BehrensG/ETH6C12MUX/img/PCB1_V1.0.jpg

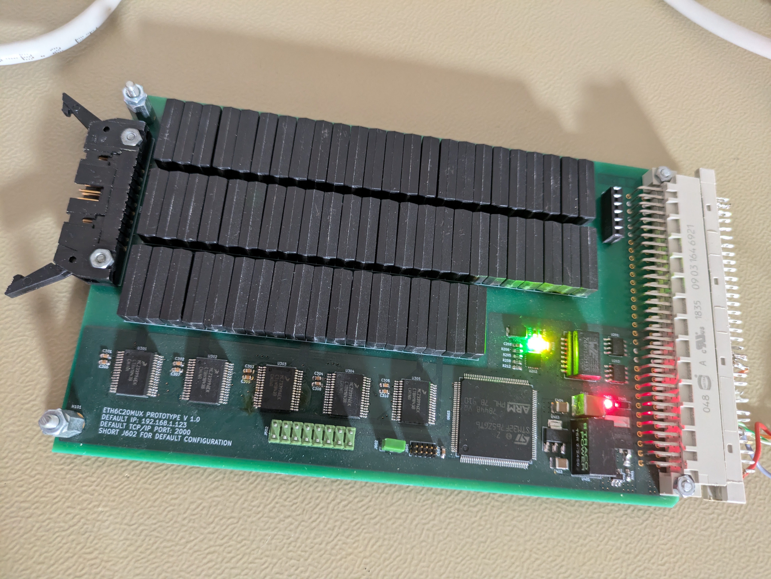
img/PCB1_V1.0.jpg
