BehrensG/ETH6C12MUX/img/PCB3_V1.0.jpg

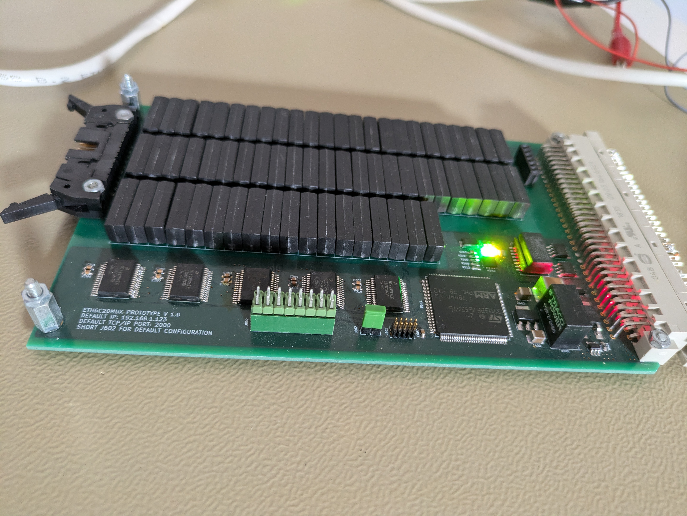
img/PCB3_V1.0.jpg
