BehrensG/ETH6C12MUX/hardware/project/PDF/ETH6C20MUX-B_SilkS.pdf

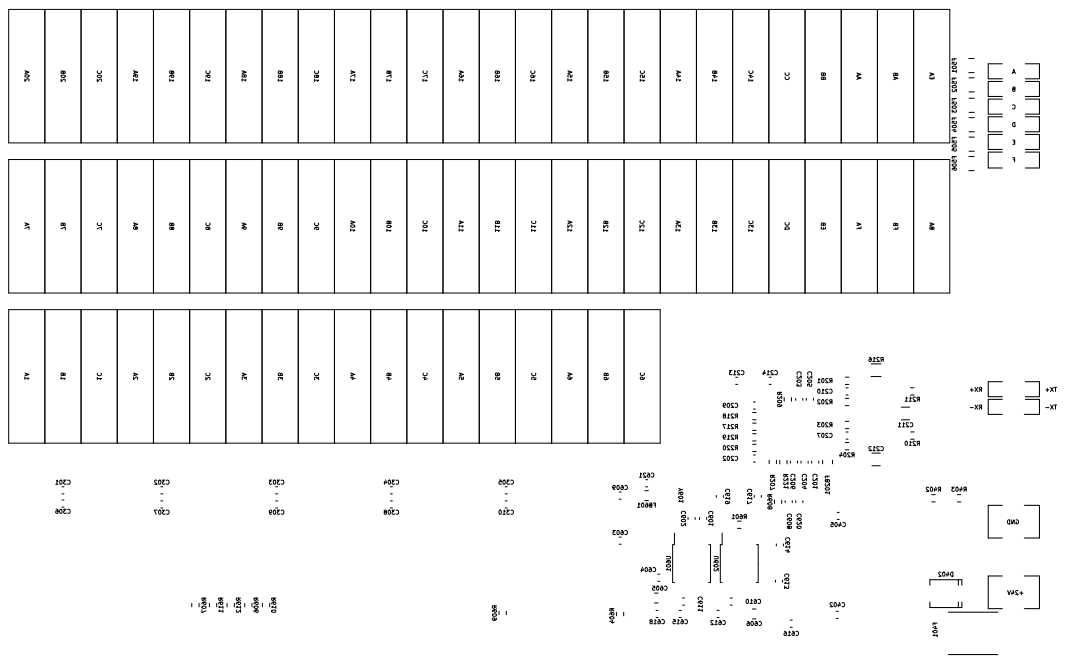
[picture p3: page 1]

RX- RX+ TX- TX+ GND
