BehrensG/ETH6C12MUX/hardware/project/PDF/SPI6C20MUX-F_SilkS.pdf

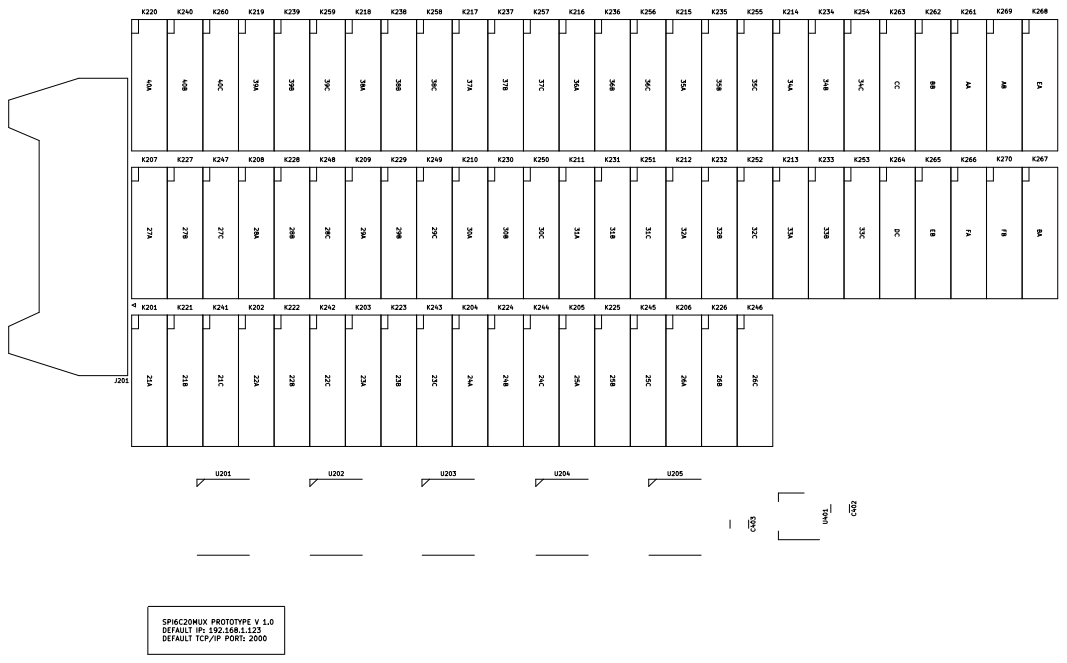
[picture p4: page 1]

27A 27B 27C 28A 28B 28C 29A 29B 29C 30A 30B 30C 31A 31B 31C 32A 32B 32C 33A 33B 33C DCEB ABEA FABA 21B 21C 22A 22B 22C 23A 23B 23C 24A 24B 24C 25A 25B 25C 26A 26B 26C FB 21A 40A 40B 40C 39A 39B 39C 38A 38B 38C 37A 37B 37C 36A 36B 36C 35A 35B 35C 34A 34B 34C CCBBAA

SPI6C20MUX PROTOTYPE V 1.0 DEFAULT IP: 192.168.1.123 DEFAULT TCP/IP PORT: 2000
