BehrensG/ETH6C12MUX/hardware/project/PDF/ETH6C20MUX-B_Mask.pdf

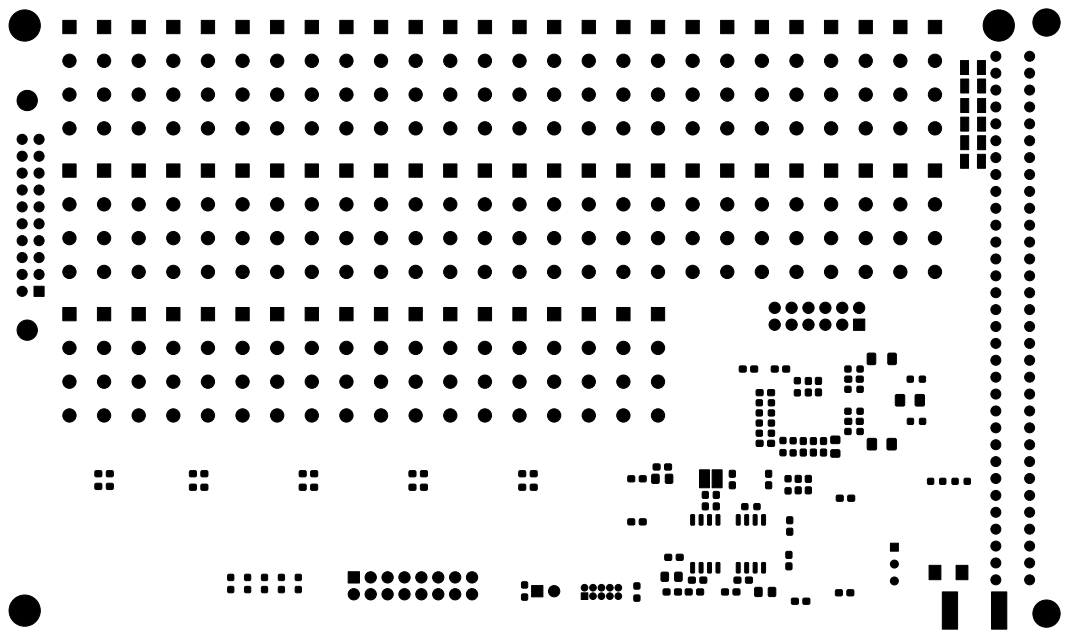
[picture p5: page 1]
