BehrensG/ETH6C12MUX/hardware/project/PDF/ETH6C20MUX-B_Paste.pdf

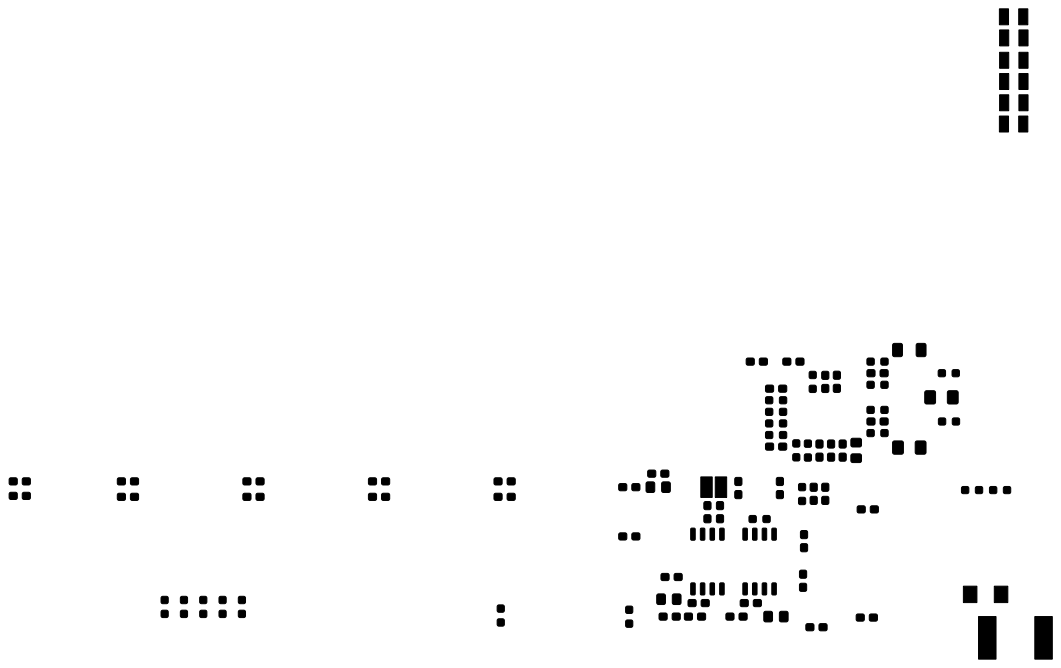
[picture p6: page 1]
