BehrensG/ETH6C12MUX/hardware/project/PDF/ETH6C20MUX-Bottom.pdf

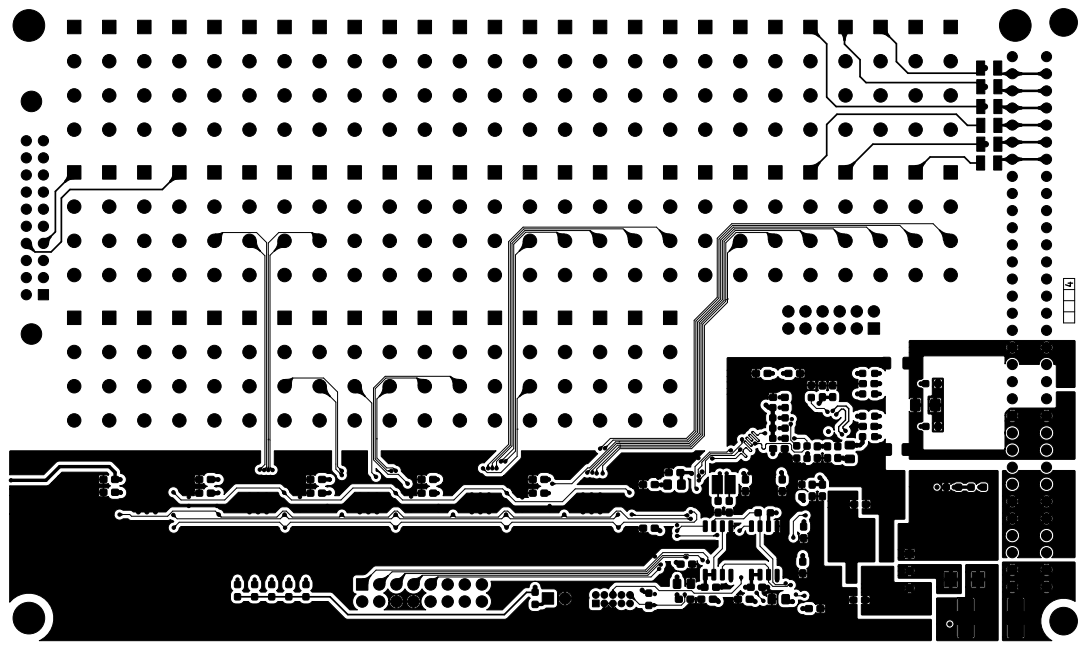
[picture p7: page 1]
