BehrensG/ETH6C12MUX/hardware/project/PDF/ETH6C20MUX-F_Mask.pdf

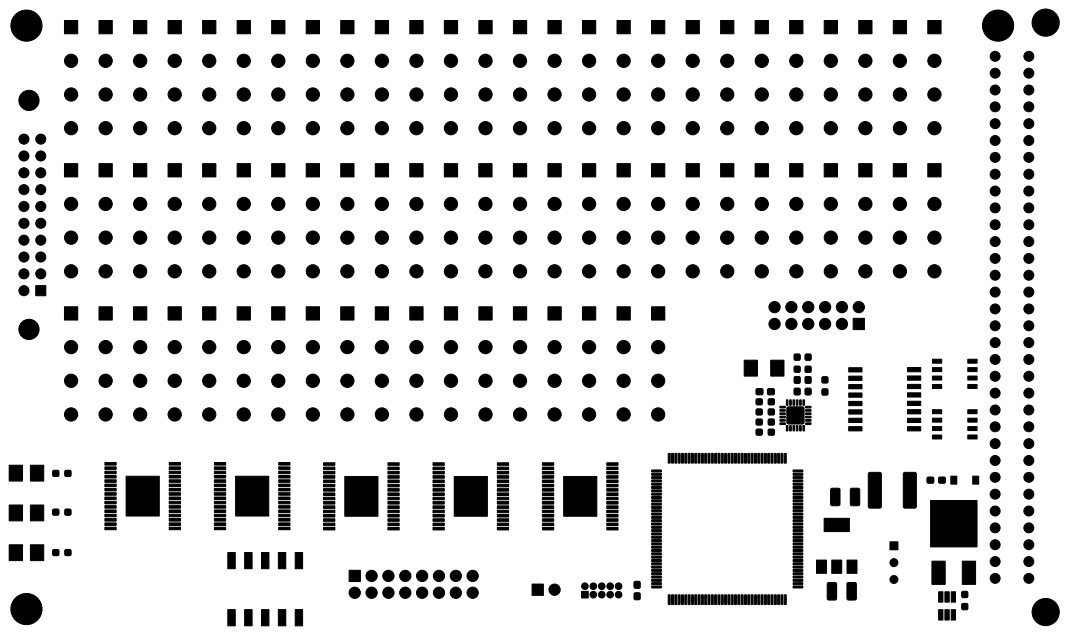
[picture p8: page 1]
