BehrensG/ETH6C12MUX/hardware/project/PDF/ETH6C20MUX-F_Paste.pdf

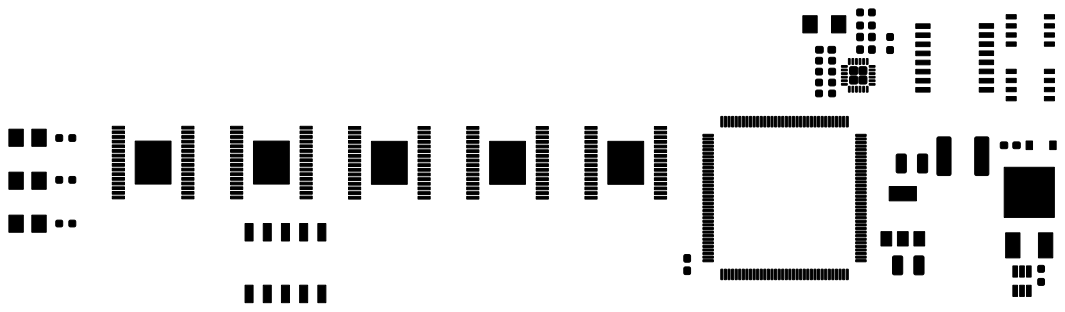
[picture p9: page 1]
