BehrensG/ETH6C12MUX/hardware/project/PDF/ETH6C20MUX-F_SilkS.pdf

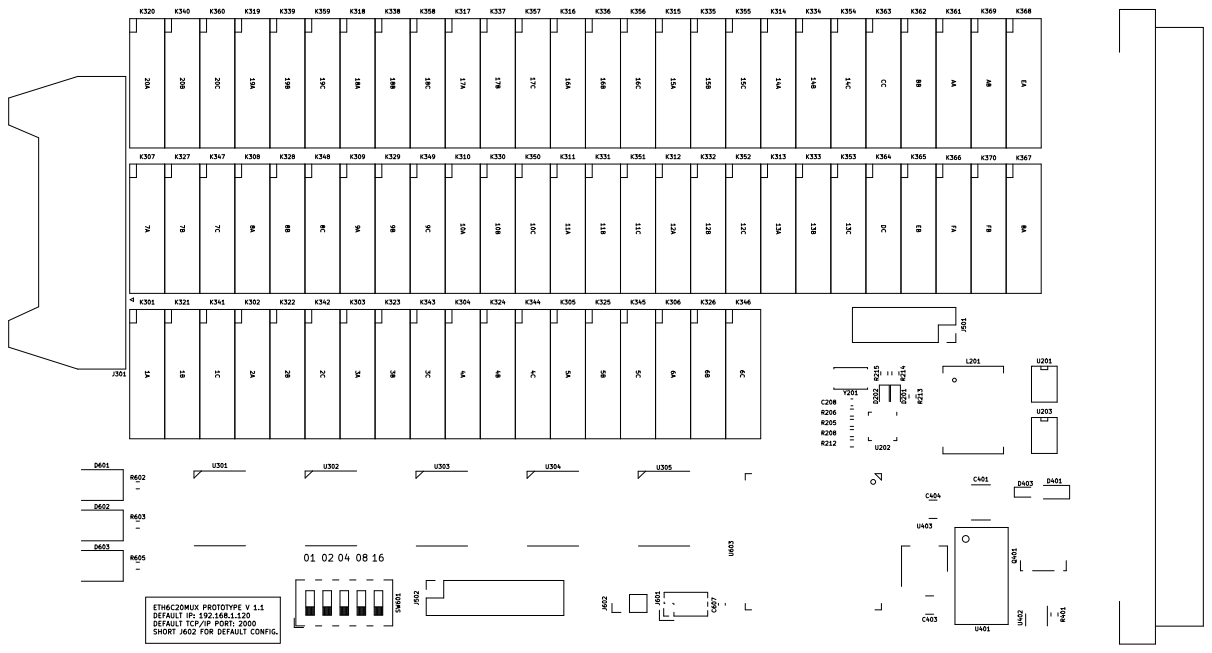
[picture p10: page 1]
