BehrensG/ETH6C12MUX/hardware/project/PDF/ETH6C20MUX-GND.pdf

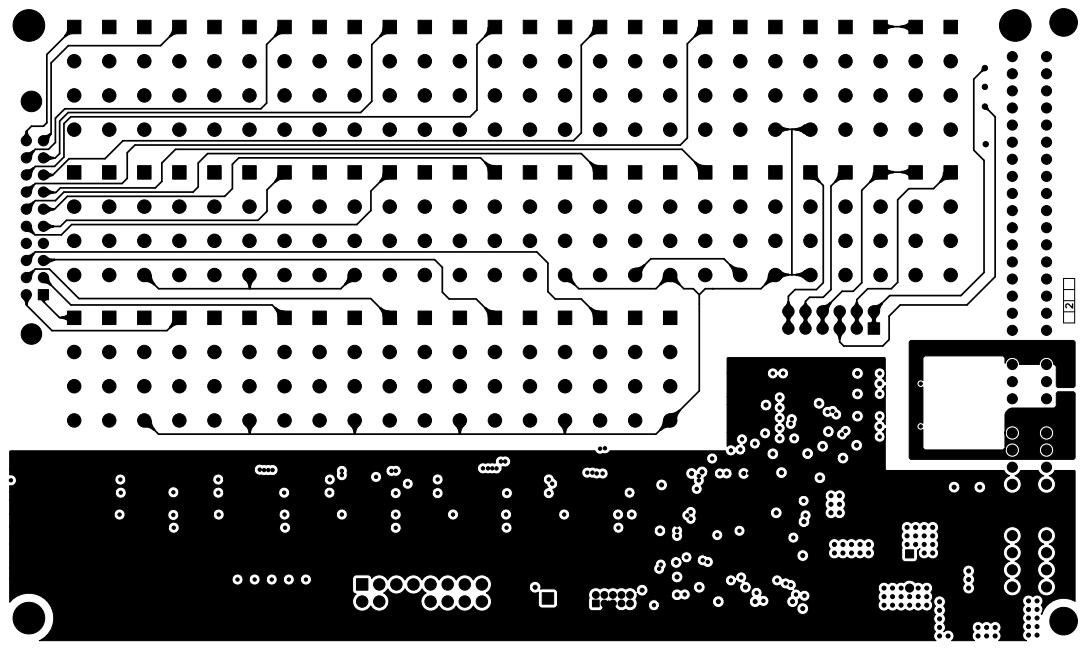
[picture p11: page 1]
