BehrensG/ETH6C12MUX/hardware/project/PDF/ETH6C20MUX-Power.pdf

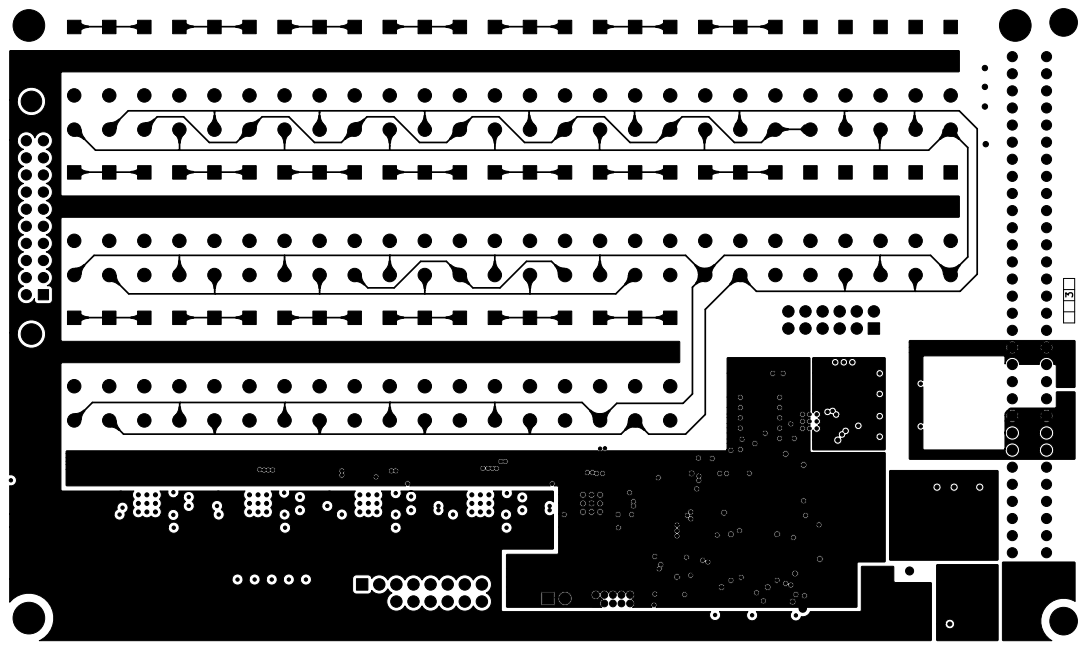
[picture p12: page 1]
