BehrensG/ETH6C12MUX/hardware/project/PDF/ETH6C20MUX-Top.pdf

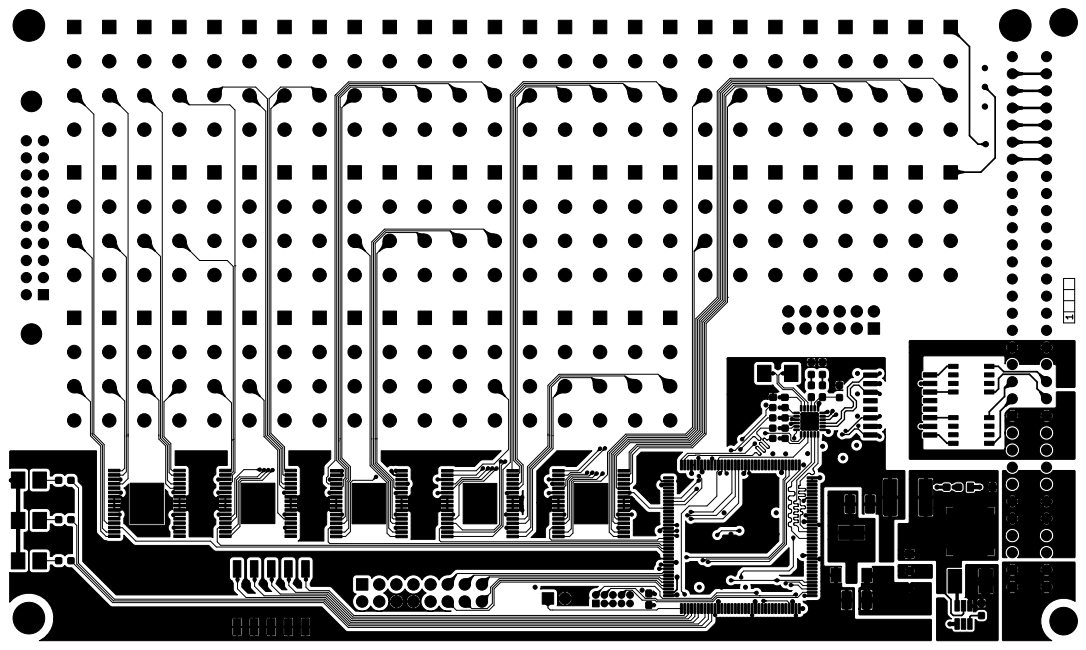
[picture p13: page 1]
