BehrensG/ETH6C12MUX/hardware/project/PDF/SPI6C20MUX-B_Mask.pdf

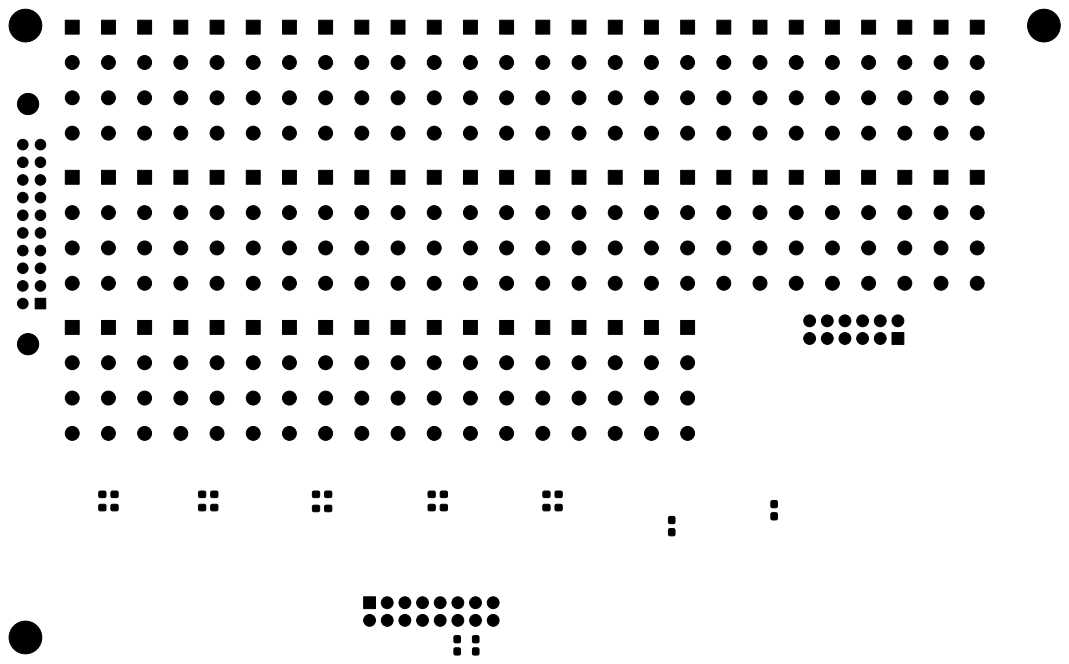
[picture p14: page 1]
