BehrensG/ETH6C12MUX/hardware/project/PDF/SPI6C20MUX-B_Paste.pdf

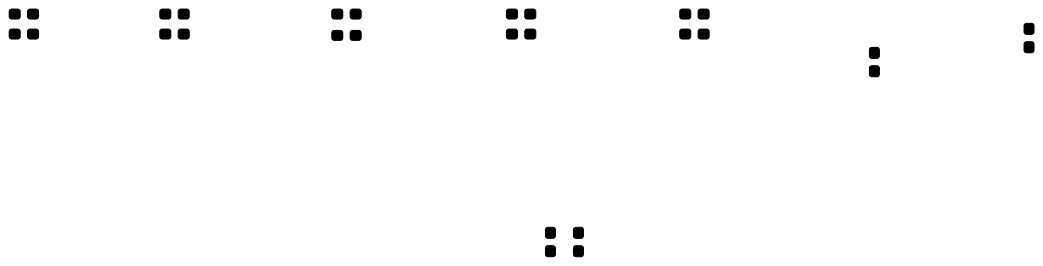
[picture p15: page 1]
