BehrensG/ETH6C12MUX/hardware/project/PDF/SPI6C20MUX-Bottom.pdf

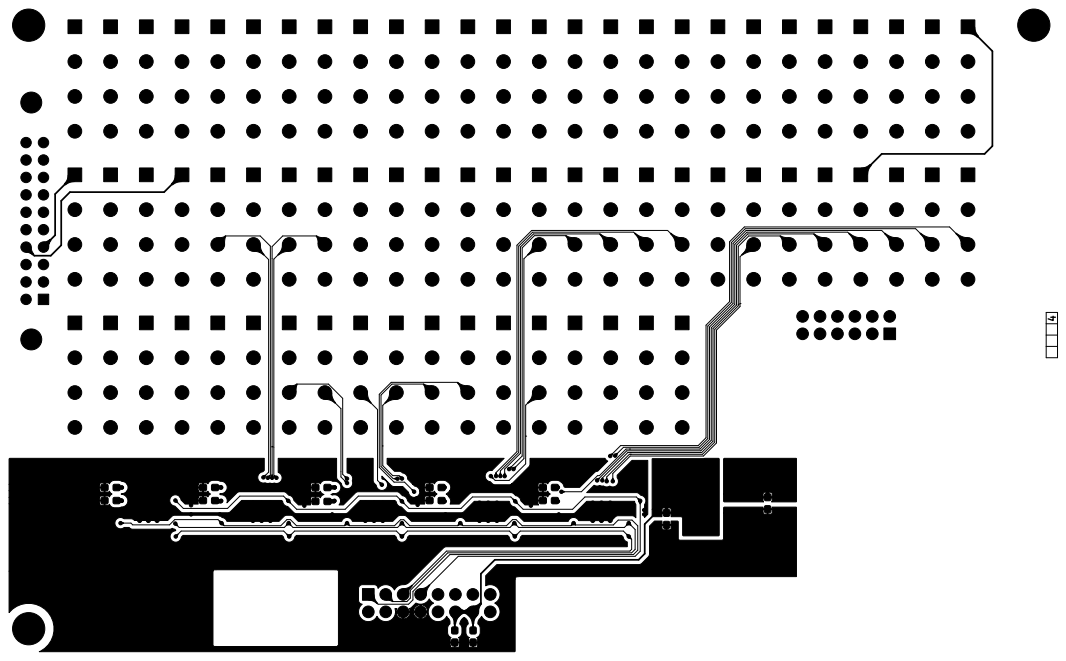
[picture p17: page 1]
