BehrensG/ETH6C12MUX/hardware/project/PDF/SPI6C20MUX-F_Mask.pdf

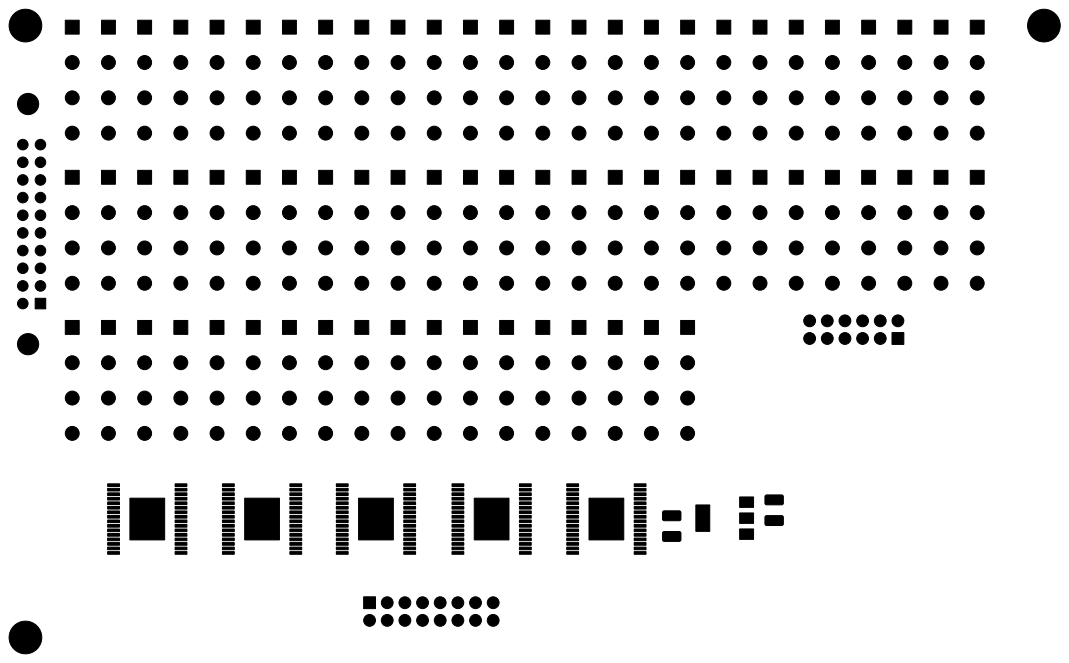
[picture p18: page 1]
