BehrensG/ETH6C12MUX/hardware/project/PDF/SPI6C20MUX-GND.pdf

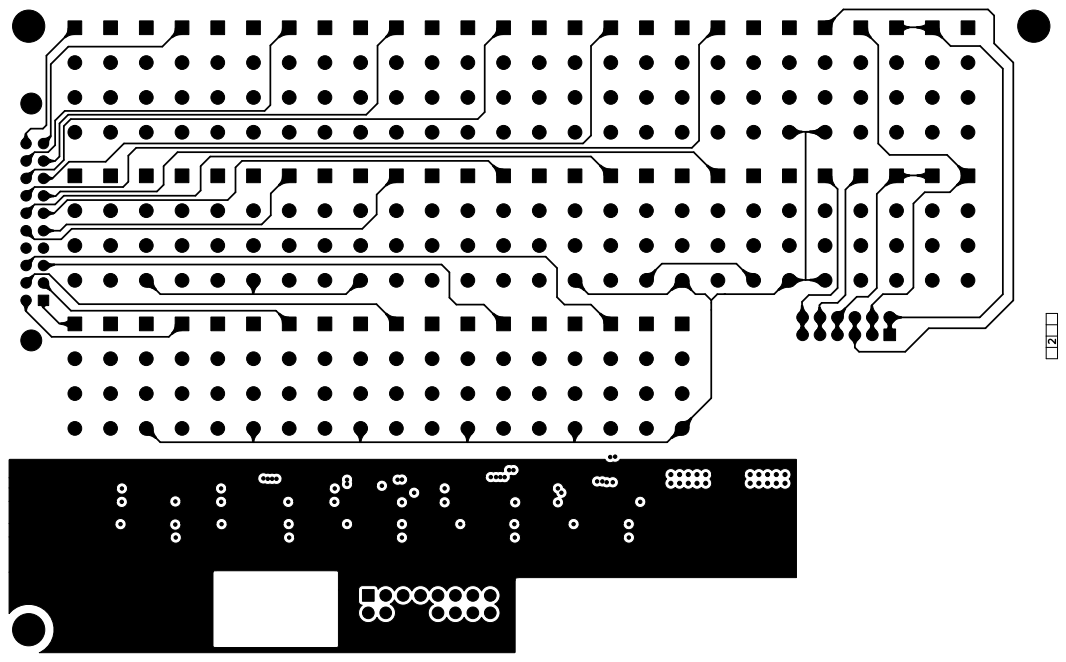
[picture p19: page 1]
