BehrensG/ETH6C12MUX/hardware/project/PDF/SPI6C20MUX-Power.pdf

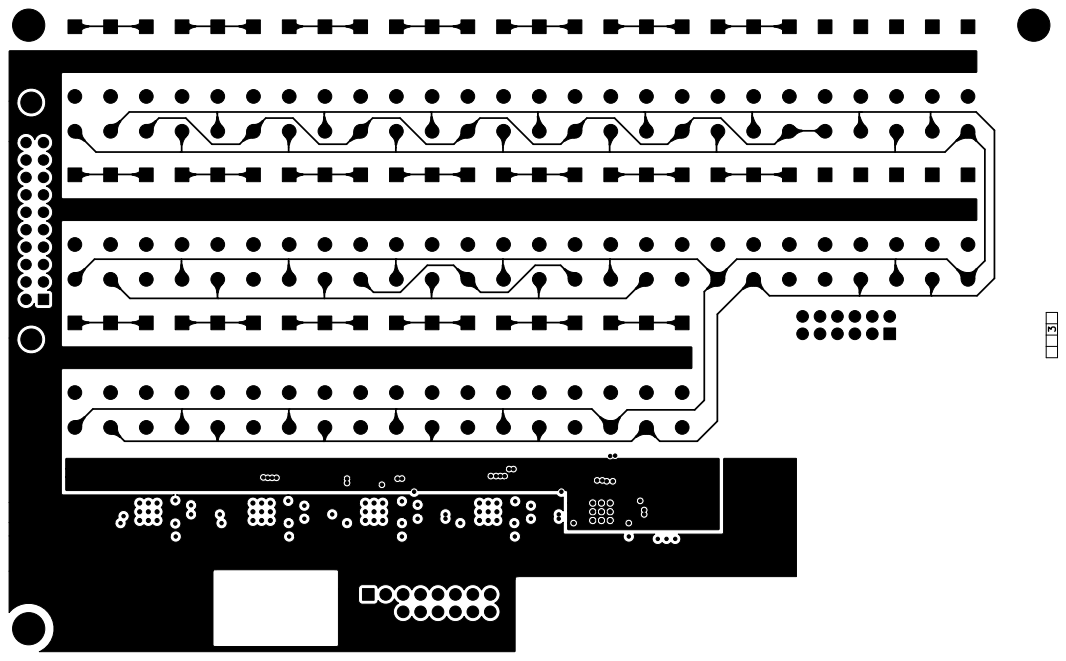
[picture p20: page 1]
