BehrensG/ETH6C12MUX/hardware/project/PDF/SPI6C20MUX-Top.pdf

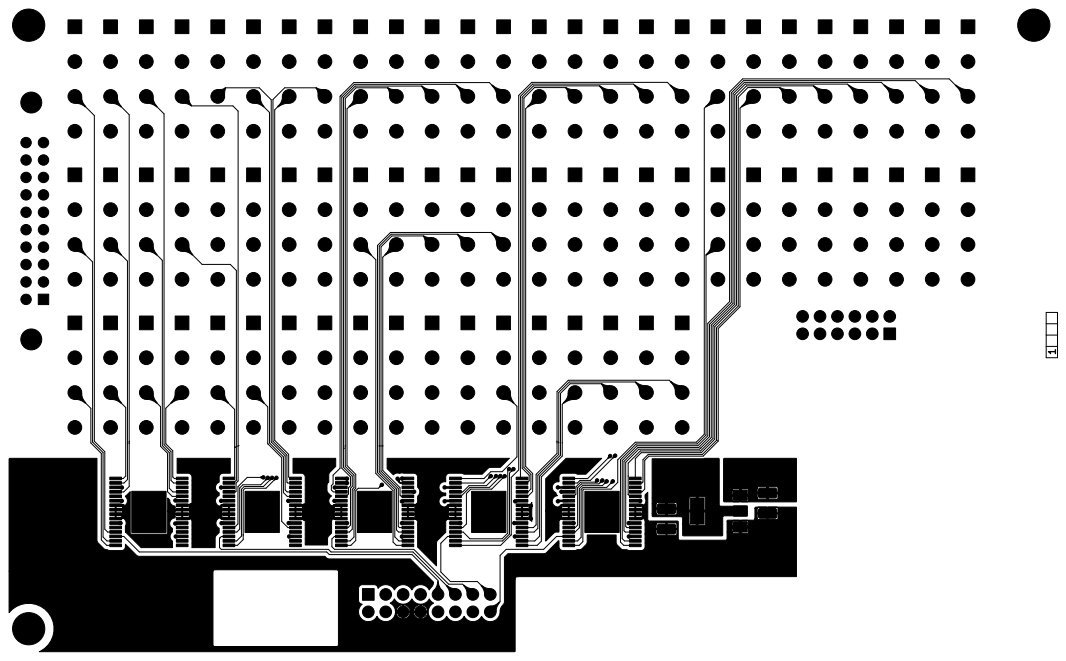
[picture p21: page 1]
