BehrensG/ETH6C12MUX/hardware/project/SPI6C20MUX/SPI6C20MUX.kicad_pcb

## KiCad design hardware/project/SPI6C20MUX/SPI6C20MUX.kicad_pcb (2021-03-21)

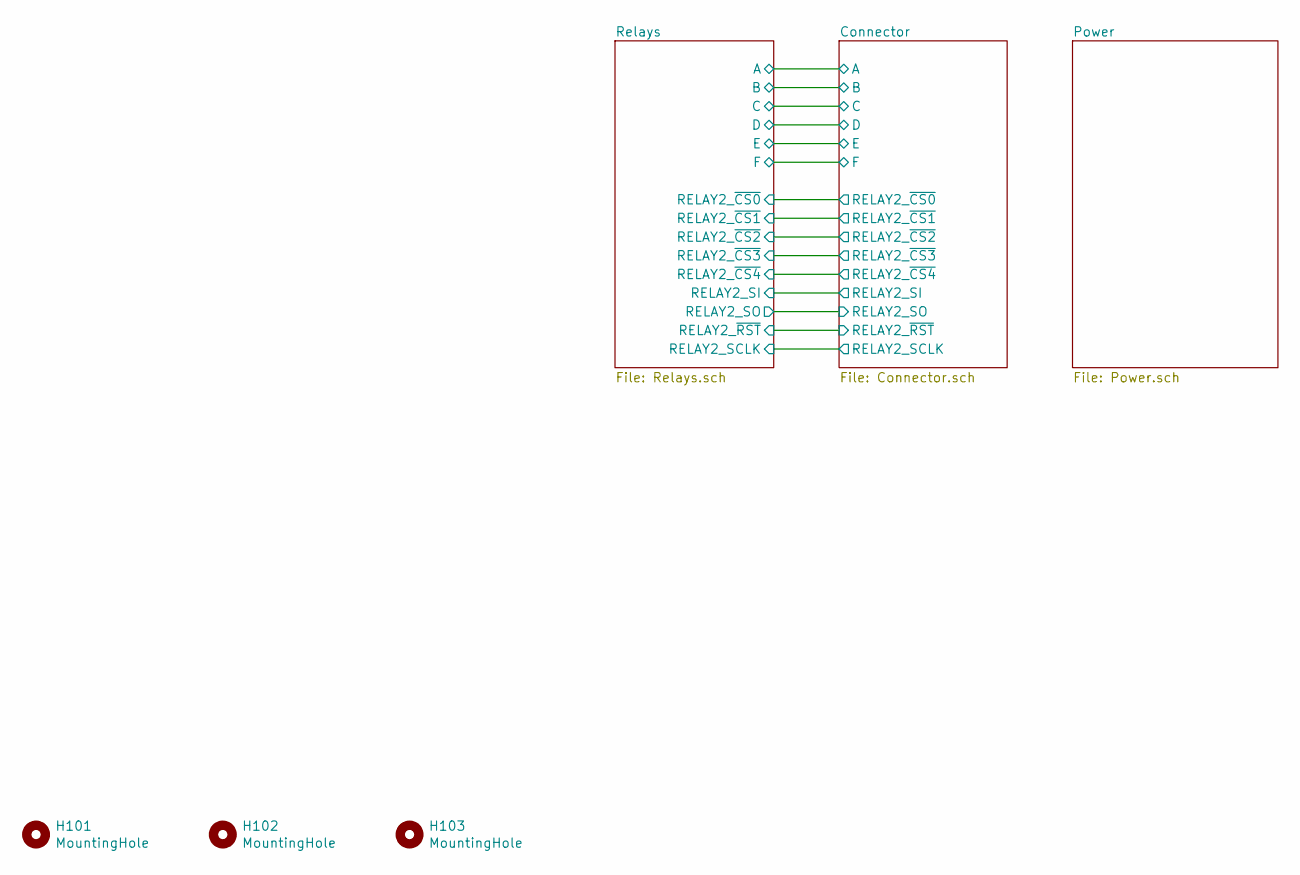
[picture p22: schematic SPI6C20MUX.sch]

Parts:
H101, H102, H103: MountingHole; MountingHole_2.7mm_M2.5_DIN965_Pad

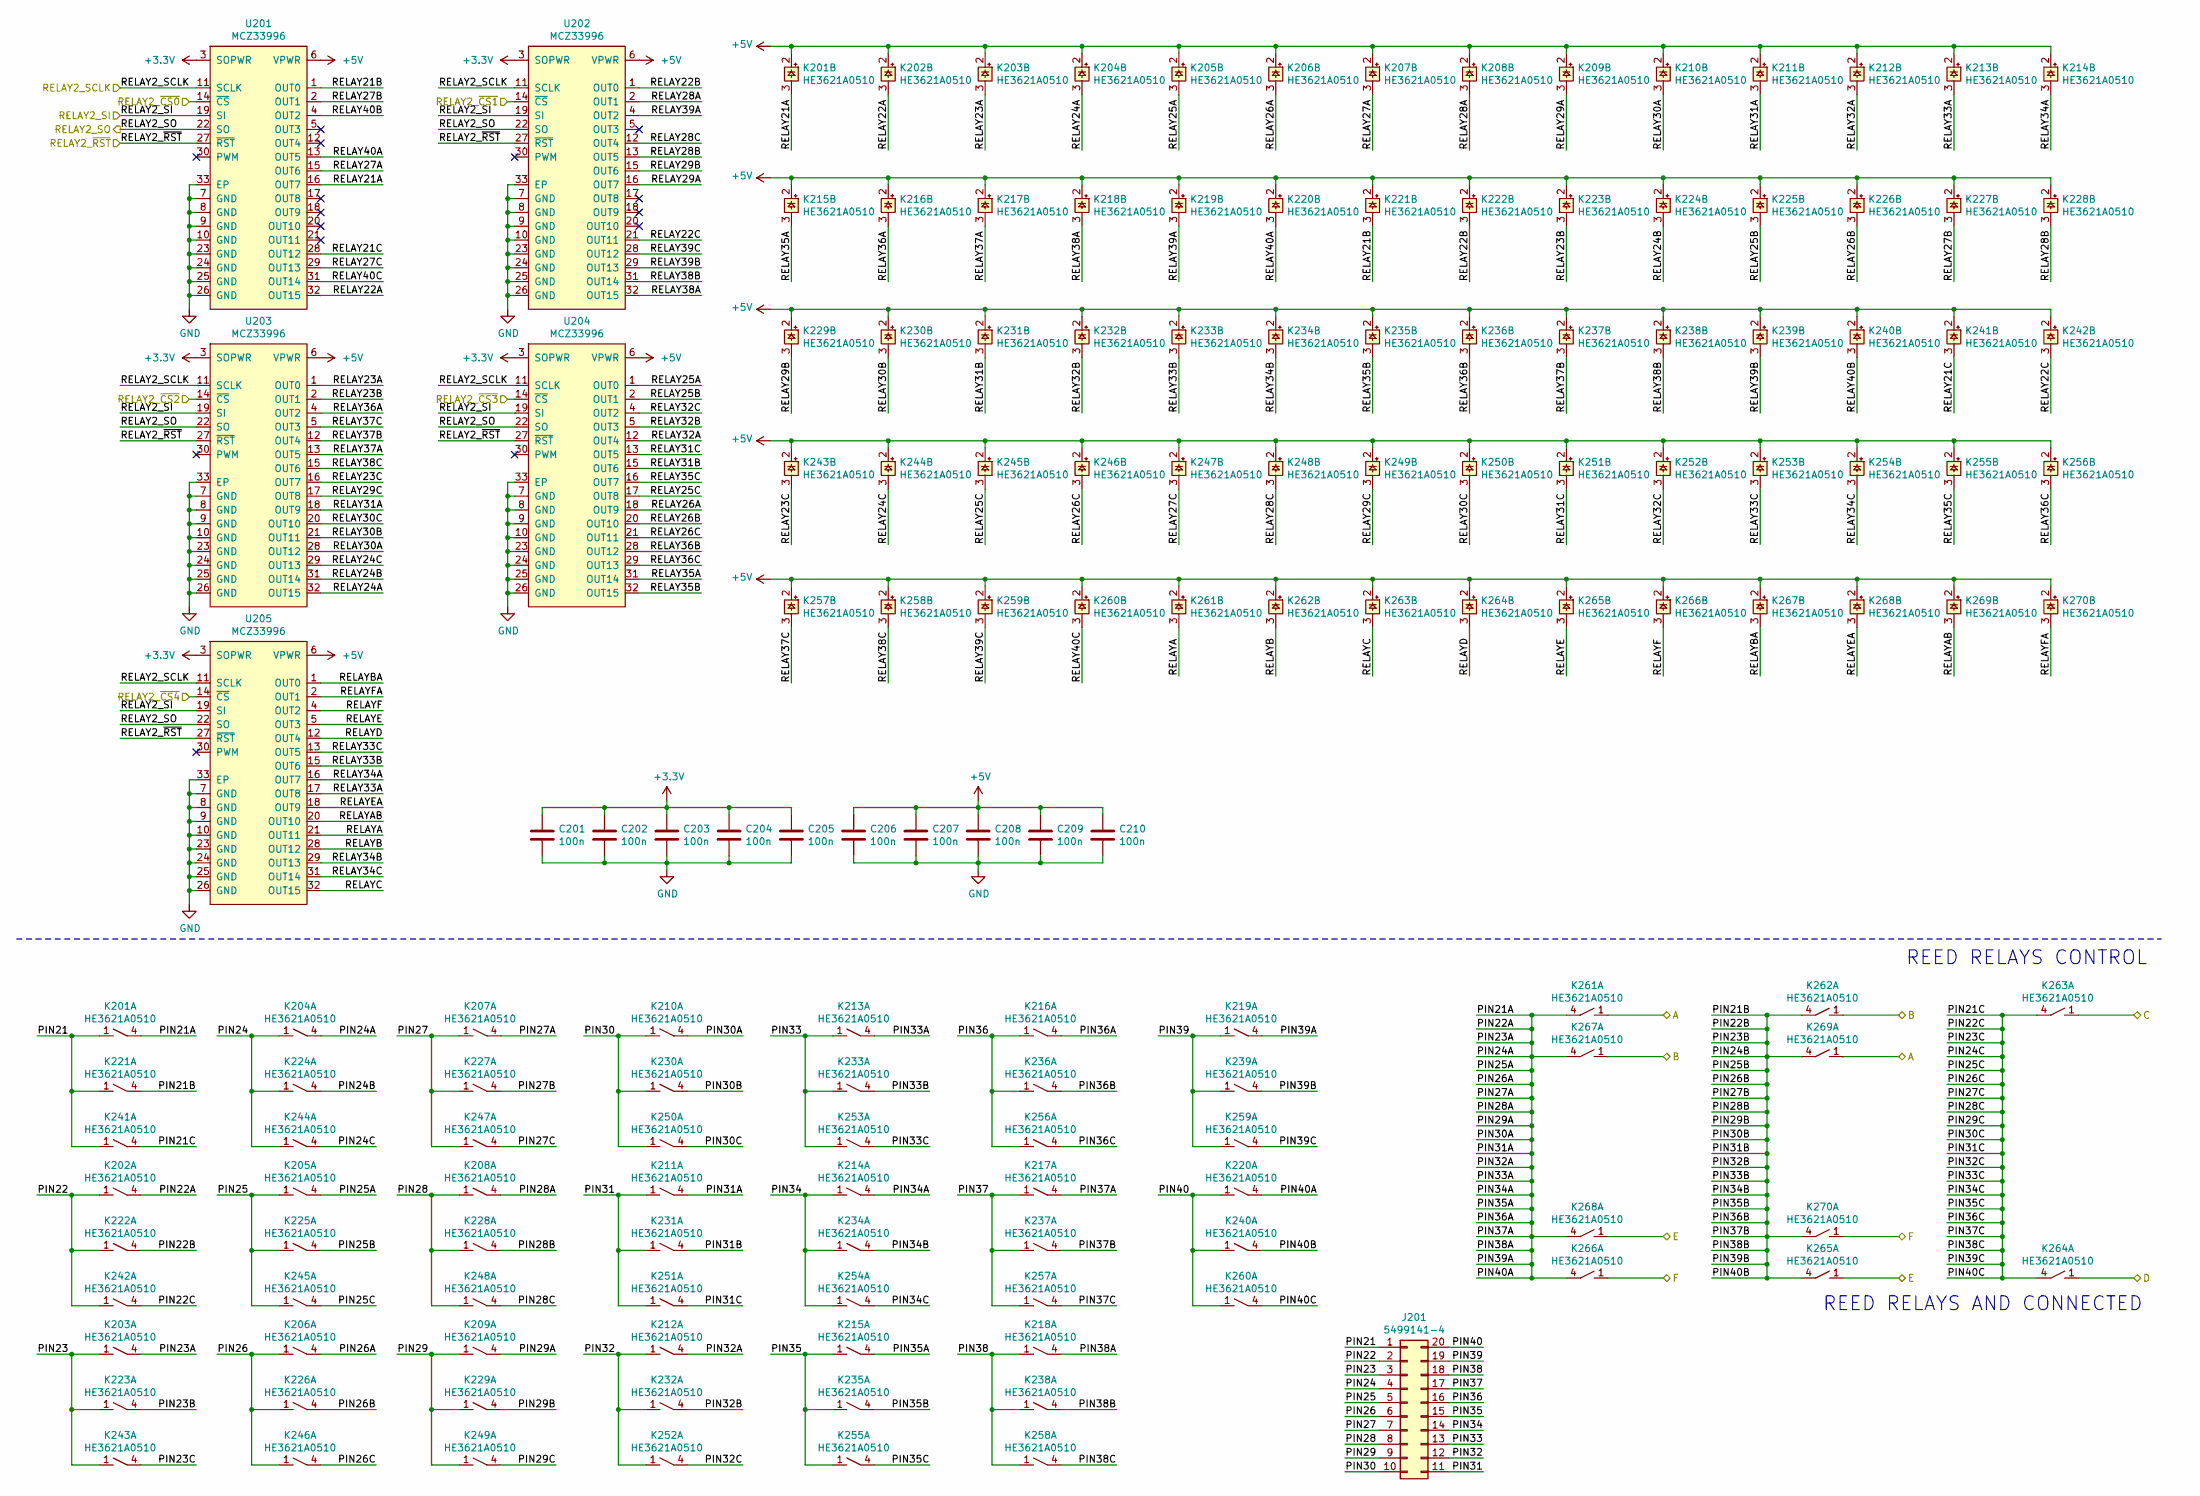
[picture p23: schematic Relays.sch]

Parts:
C201, C202, C203, C204, C205, C206, C207, C208, C209, C210: 100n; C_0603_1608Metric_Pad1.05x0.95mm_HandSolder
J201: 5499141-4; IDC-Header_2x10_P2.54mm_Horizontal_Lock
K201, K202, K203, K204, K205, K206, K207, K208, K209, K210, K211, K212, K213, K214, K215, K216, K217, K218, K219, K220, K221, K222, K223, K224, K225, K226, K227, K228, K229, K230, K231, K232, K233, K234, K235, K236, K237, K238, K239, K240, K241, K242, K243, K244, K245, K246, K247, K248, K249, K250, K251, K252, K253, K254, K255, K256, K257, K258, K259, K260, K261, K262, K263, K264, K265, K266, K267, K268, K269, K270: HE3621A0510; HE360_x-5331272-5
U201, U202, U203, U204, U205: MCZ33996; HSOP-32-1EP_7.5x11.0mm_P0.65mm_ThermalVias

Connections:
+3V3: C201.1, C202.1, C203.1, C204.1, C205.1, U201.3 (SOPWR), U202.3 (SOPWR), U203.3 (SOPWR), U204.3 (SOPWR), U205.3 (SOPWR); also elsewhere on the board
+5V: C206.1, C207.1, C208.1, C209.1, C210.1, K201.2, K202.2, K203.2, K204.2, K205.2, K206.2, K207.2, K208.2, K209.2, K210.2, K211.2, K212.2, K213.2, K214.2, K215.2, K216.2, K217.2, K218.2, K219.2, K220.2, K221.2, K222.2, K223.2, K224.2, K225.2, K226.2, K227.2, K228.2, K229.2, K230.2, K231.2, K232.2, K233.2, K234.2, K235.2, K236.2, K237.2, K238.2, K239.2, K240.2, K241.2, K242.2, K243.2, K244.2, K245.2, K246.2, K247.2, K248.2, K249.2, K250.2, K251.2, K252.2, K253.2, K254.2, K255.2, K256.2, K257.2, K258.2, K259.2, K260.2, K261.2, K262.2, K263.2, K264.2, K265.2, K266.2, K267.2, K268.2, K269.2, K270.2, U201.6 (VPWR), U202.6 (VPWR), U203.6 (VPWR), U204.6 (VPWR), U205.6 (VPWR); also elsewhere on the board
/Connector/A: K261.1, K269.1; also elsewhere on the board
/Connector/B: K262.1, K267.1; also elsewhere on the board
/Connector/C: K263.1; also elsewhere on the board
/Connector/D: K264.1; also elsewhere on the board
/Connector/E: K265.1, K268.1; also elsewhere on the board
/Connector/F: K266.1, K270.1; also elsewhere on the board
/Connector/RELAY2_SCLK: U201.11 (SCLK), U202.11 (SCLK), U203.11 (SCLK), U204.11 (SCLK), U205.11 (SCLK); also elsewhere on the board
/Connector/RELAY2_SI: U201.19 (SI), U202.19 (SI), U203.19 (SI), U204.19 (SI), U205.19 (SI); also elsewhere on the board
/Connector/RELAY2_SO: U201.22 (SO), U202.22 (SO), U203.22 (SO), U204.22 (SO), U205.22 (SO); also elsewhere on the board
/Connector/RELAY2_~CS0: U201.14 (~CS); also elsewhere on the board
/Connector/RELAY2_~CS1: U202.14 (~CS); also elsewhere on the board
/Connector/RELAY2_~CS2: U203.14 (~CS); also elsewhere on the board
/Connector/RELAY2_~CS3: U204.14 (~CS); also elsewhere on the board
/Connector/RELAY2_~CS4: U205.14 (~CS); also elsewhere on the board
/Connector/RELAY2_~RST: U201.27 (~RST), U202.27 (~RST), U203.27 (~RST), U204.27 (~RST), U205.27 (~RST); also elsewhere on the board
/Relays/PIN21: J201.1, K201.1, K221.1, K241.1
/Relays/PIN21A: K201.4, K202.4, K203.4, K204.4, K205.4, K206.4, K207.4, K208.4, K209.4, K210.4, K211.4, K212.4, K213.4, K214.4, K215.4, K216.4, K217.4, K218.4, K219.4, K220.4, K261.4, K266.4, K267.4, K268.4
/Relays/PIN21B: K221.4, K222.4, K223.4, K224.4, K225.4, K226.4, K227.4, K228.4, K229.4, K230.4, K231.4, K232.4, K233.4, K234.4, K235.4, K236.4, K237.4, K238.4, K239.4, K240.4, K262.4, K265.4, K269.4, K270.4
/Relays/PIN21C: K241.4, K242.4, K243.4, K244.4, K245.4, K246.4, K247.4, K248.4, K249.4, K250.4, K251.4, K252.4, K253.4, K254.4, K255.4, K256.4, K257.4, K258.4, K259.4, K260.4, K263.4, K264.4
/Relays/PIN22: J201.2, K202.1, K222.1, K242.1
/Relays/PIN23: J201.3, K203.1, K223.1, K243.1
/Relays/PIN24: J201.4, K204.1, K224.1, K244.1
/Relays/PIN25: J201.5, K205.1, K225.1, K245.1
/Relays/PIN26: J201.6, K206.1, K226.1, K246.1
/Relays/PIN27: J201.7, K207.1, K227.1, K247.1
/Relays/PIN28: J201.8, K208.1, K228.1, K248.1
/Relays/PIN29: J201.9, K209.1, K229.1, K249.1
/Relays/PIN30: J201.10, K210.1, K230.1, K250.1
/Relays/PIN31: J201.11, K211.1, K231.1, K251.1
/Relays/PIN32: J201.12, K212.1, K232.1, K252.1
/Relays/PIN33: J201.13, K213.1, K233.1, K253.1
/Relays/PIN34: J201.14, K214.1, K234.1, K254.1
/Relays/PIN35: J201.15, K215.1, K235.1, K255.1
/Relays/PIN36: J201.16, K216.1, K236.1, K256.1
/Relays/PIN37: J201.17, K217.1, K237.1, K257.1
/Relays/PIN38: J201.18, K218.1, K238.1, K258.1
/Relays/PIN39: J201.19, K219.1, K239.1, K259.1
/Relays/PIN40: J201.20, K220.1, K240.1, K260.1
/Relays/RELAY21A: K201.3, U201.16 (OUT7)
/Relays/RELAY21B: K221.3, U201.1 (OUT0)
/Relays/RELAY21C: K241.3, U201.28 (OUT12)
/Relays/RELAY22A: K202.3, U201.32 (OUT15)
/Relays/RELAY22B: K222.3, U202.1 (OUT0)
/Relays/RELAY22C: K242.3, U202.21 (OUT11)
/Relays/RELAY23A: K203.3, U203.1 (OUT0)
/Relays/RELAY23B: K223.3, U203.2 (OUT1)
/Relays/RELAY23C: K243.3, U203.16 (OUT7)
/Relays/RELAY24A: K204.3, U203.32 (OUT15)
/Relays/RELAY24B: K224.3, U203.31 (OUT14)
/Relays/RELAY24C: K244.3, U203.29 (OUT13)
/Relays/RELAY25A: K205.3, U204.1 (OUT0)
/Relays/RELAY25B: K225.3, U204.2 (OUT1)
/Relays/RELAY25C: K245.3, U204.17 (OUT8)
/Relays/RELAY26A: K206.3, U204.18 (OUT9)
/Relays/RELAY26B: K226.3, U204.20 (OUT10)
/Relays/RELAY26C: K246.3, U204.21 (OUT11)
/Relays/RELAY27A: K207.3, U201.15 (OUT6)
/Relays/RELAY27B: K227.3, U201.2 (OUT1)
/Relays/RELAY27C: K247.3, U201.29 (OUT13)
/Relays/RELAY28A: K208.3, U202.2 (OUT1)
/Relays/RELAY28B: K228.3, U202.13 (OUT5)
/Relays/RELAY28C: K248.3, U202.12 (OUT4)
/Relays/RELAY29A: K209.3, U202.16 (OUT7)
/Relays/RELAY29B: K229.3, U202.15 (OUT6)
/Relays/RELAY29C: K249.3, U203.17 (OUT8)
/Relays/RELAY30A: K210.3, U203.28 (OUT12)
/Relays/RELAY30B: K230.3, U203.21 (OUT11)
/Relays/RELAY30C: K250.3, U203.20 (OUT10)
/Relays/RELAY31A: K211.3, U203.18 (OUT9)
/Relays/RELAY31B: K231.3, U204.15 (OUT6)
/Relays/RELAY31C: K251.3, U204.13 (OUT5)
/Relays/RELAY32A: K212.3, U204.12 (OUT4)
/Relays/RELAY32B: K232.3, U204.5 (OUT3)
/Relays/RELAY32C: K252.3, U204.4 (OUT2)
/Relays/RELAY33A: K213.3, U205.17 (OUT8)
/Relays/RELAY33B: K233.3, U205.15 (OUT6)
/Relays/RELAY33C: K253.3, U205.13 (OUT5)
/Relays/RELAY34A: K214.3, U205.16 (OUT7)
/Relays/RELAY34B: K234.3, U205.29 (OUT13)
/Relays/RELAY34C: K254.3, U205.31 (OUT14)
/Relays/RELAY35A: K215.3, U204.31 (OUT14)
/Relays/RELAY35B: K235.3, U204.32 (OUT15)
/Relays/RELAY35C: K255.3, U204.16 (OUT7)
/Relays/RELAY36A: K216.3, U203.4 (OUT2)
/Relays/RELAY36B: K236.3, U204.28 (OUT12)
/Relays/RELAY36C: K256.3, U204.29 (OUT13)
/Relays/RELAY37A: K217.3, U203.13 (OUT5)
/Relays/RELAY37B: K237.3, U203.12 (OUT4)
/Relays/RELAY37C: K257.3, U203.5 (OUT3)
/Relays/RELAY38A: K218.3, U202.32 (OUT15)
/Relays/RELAY38B: K238.3, U202.31 (OUT14)
/Relays/RELAY38C: K258.3, U203.15 (OUT6)
/Relays/RELAY39A: K219.3, U202.4 (OUT2)
/Relays/RELAY39B: K239.3, U202.29 (OUT13)
/Relays/RELAY39C: K259.3, U202.28 (OUT12)
/Relays/RELAY40A: K220.3, U201.13 (OUT5)
/Relays/RELAY40B: K240.3, U201.4 (OUT2)
/Relays/RELAY40C: K260.3, U201.31 (OUT14)
/Relays/RELAYA: K261.3, U205.21 (OUT11)
/Relays/RELAYAB: K269.3, U205.20 (OUT10)
/Relays/RELAYB: K262.3, U205.28 (OUT12)
/Relays/RELAYBA: K267.3, U205.1 (OUT0)
/Relays/RELAYC: K263.3, U205.32 (OUT15)
/Relays/RELAYD: K264.3, U205.12 (OUT4)
/Relays/RELAYE: K265.3, U205.5 (OUT3)
/Relays/RELAYEA: K268.3, U205.18 (OUT9)
/Relays/RELAYF: K266.3, U205.4 (OUT2)
/Relays/RELAYFA: K270.3, U205.2 (OUT1)
GND: C201.2, C202.2, C203.2, C204.2, C205.2, C206.2, C207.2, C208.2, C209.2, C210.2, U201.7 (GND), U201.8 (GND), U201.9 (GND), U201.10 (GND), U201.23 (GND), U201.24 (GND), U201.25 (GND), U201.26 (GND), U201.33 (EP), U202.7 (GND), U202.8 (GND), U202.9 (GND), U202.10 (GND), U202.23 (GND), U202.24 (GND), U202.25 (GND), U202.26 (GND), U202.33 (EP), U203.7 (GND), U203.8 (GND), U203.9 (GND), U203.10 (GND), U203.23 (GND), U203.24 (GND), U203.25 (GND), U203.26 (GND), U203.33 (EP), U204.7 (GND), U204.8 (GND), U204.9 (GND), U204.10 (GND), U204.23 (GND), U204.24 (GND), U204.25 (GND), U204.26 (GND), U204.33 (EP), U205.7 (GND), U205.8 (GND), U205.9 (GND), U205.10 (GND), U205.23 (GND), U205.24 (GND), U205.25 (GND), U205.26 (GND), U205.33 (EP); also elsewhere on the board

Notes on the sheet:
REED RELAYS AND CONNECTED
REED RELAYS CONTROL

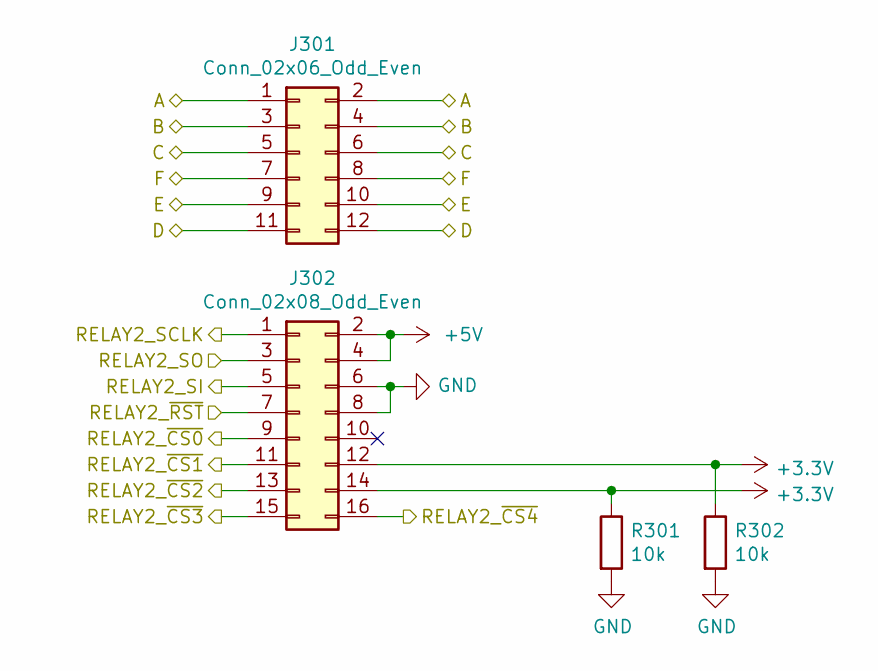
[picture p24: schematic Connector.sch]

Parts:
J301: Conn_02x06_Odd_Even; PinHeader_2x06_P2.54mm_Vertical
J302: Conn_02x08_Odd_Even; PinHeader_2x08_P2.54mm_Vertical
R301, R302: 10k; R_0603_1608Metric_Pad1.05x0.95mm_HandSolder

Connections:
+3V3: J302.12, J302.14, R301.1, R302.1; also elsewhere on the board
+5V: J302.2, J302.4; also elsewhere on the board
/Connector/A: J301.1, J301.2; also elsewhere on the board
/Connector/B: J301.3, J301.4; also elsewhere on the board
/Connector/C: J301.5, J301.6; also elsewhere on the board
/Connector/D: J301.11, J301.12; also elsewhere on the board
/Connector/E: J301.9, J301.10; also elsewhere on the board
/Connector/F: J301.7, J301.8; also elsewhere on the board
/Connector/RELAY2_SCLK: J302.1; also elsewhere on the board
/Connector/RELAY2_SI: J302.5; also elsewhere on the board
/Connector/RELAY2_SO: J302.3; also elsewhere on the board
/Connector/RELAY2_~CS0: J302.9; also elsewhere on the board
/Connector/RELAY2_~CS1: J302.11; also elsewhere on the board
/Connector/RELAY2_~CS2: J302.13; also elsewhere on the board
/Connector/RELAY2_~CS3: J302.15; also elsewhere on the board
/Connector/RELAY2_~CS4: J302.16; also elsewhere on the board
/Connector/RELAY2_~RST: J302.7; also elsewhere on the board
GND: J302.6, J302.8, R301.2, R302.2; also elsewhere on the board

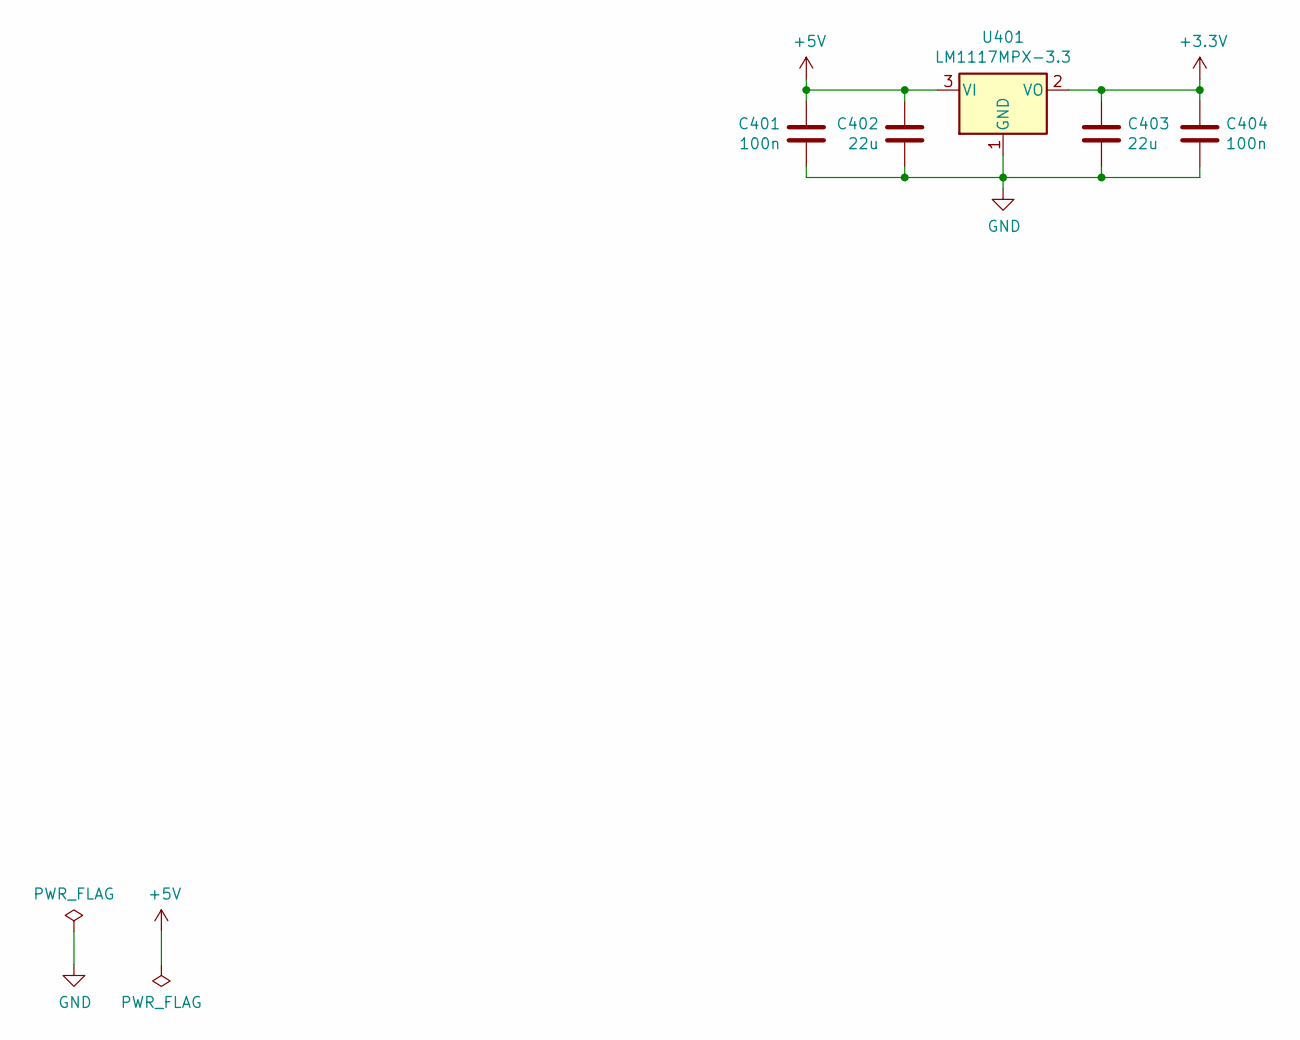
[picture p25: schematic Power.sch]

Parts:
C401, C404: 100n; C_0603_1608Metric_Pad1.05x0.95mm_HandSolder
C402, C403: 22u; C_1210_3225Metric_Pad1.42x2.65mm_HandSolder
U401: LM1117MPX-3.3; SOT-223-3_TabPin2

Connections:
+3V3: C403.1, C404.1, U401.2 (VO); also elsewhere on the board
+5V: C401.1, C402.1, U401.3 (VI); also elsewhere on the board
GND: C401.2, C402.2, C403.2, C404.2, U401.1 (GND); also elsewhere on the board

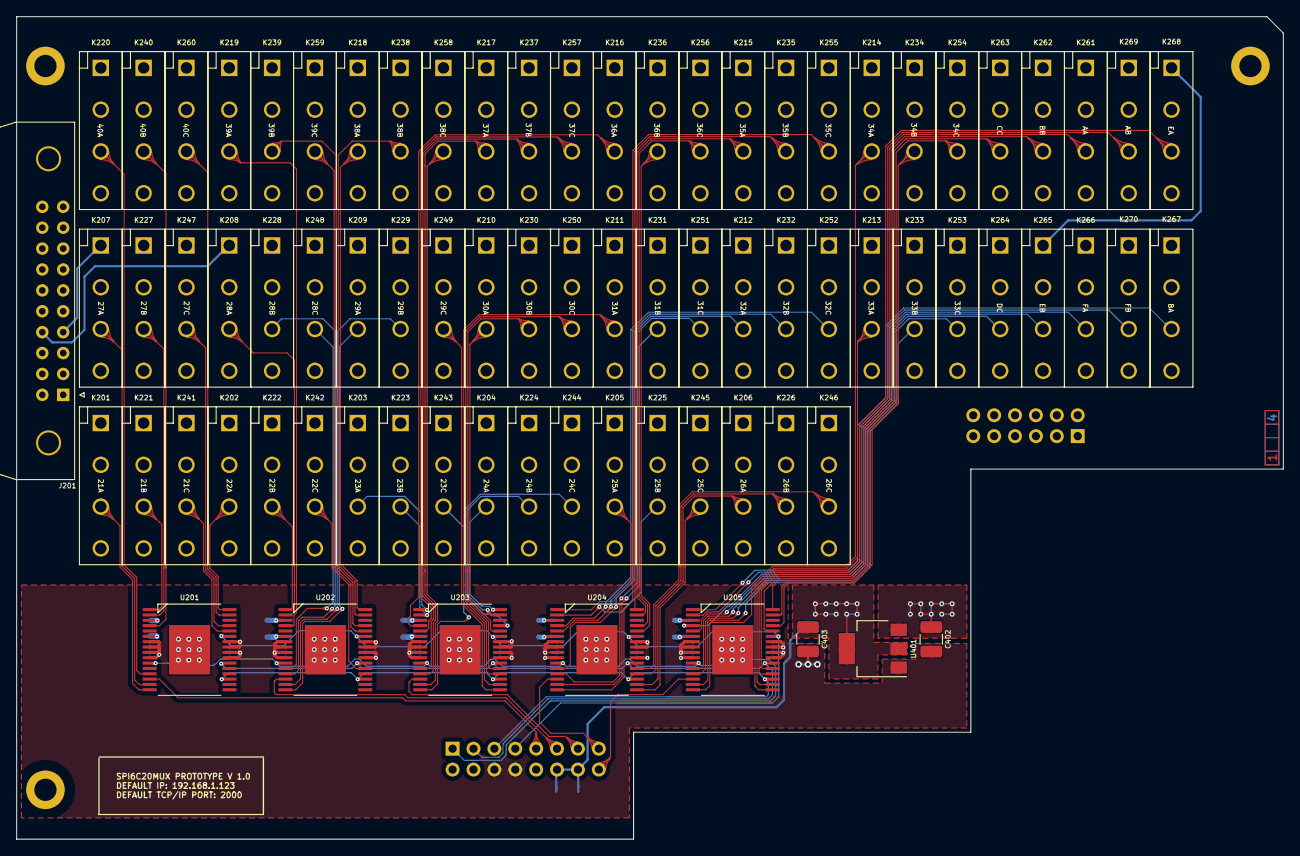
[picture p26: board SPI6C20MUX.kicad_pcb from above]

Board: 4 copper layers, 154.0 x 100.0 mm, 98 parts (0 on the bottom side), 111 nets.
