BehrensG/ETH6C12MUX/hardware/project/ETH6C20MUX/ETH6C20MUX.kicad_pcb

## KiCad design hardware/project/ETH6C20MUX/ETH6C20MUX.kicad_pcb (2021-03-21)

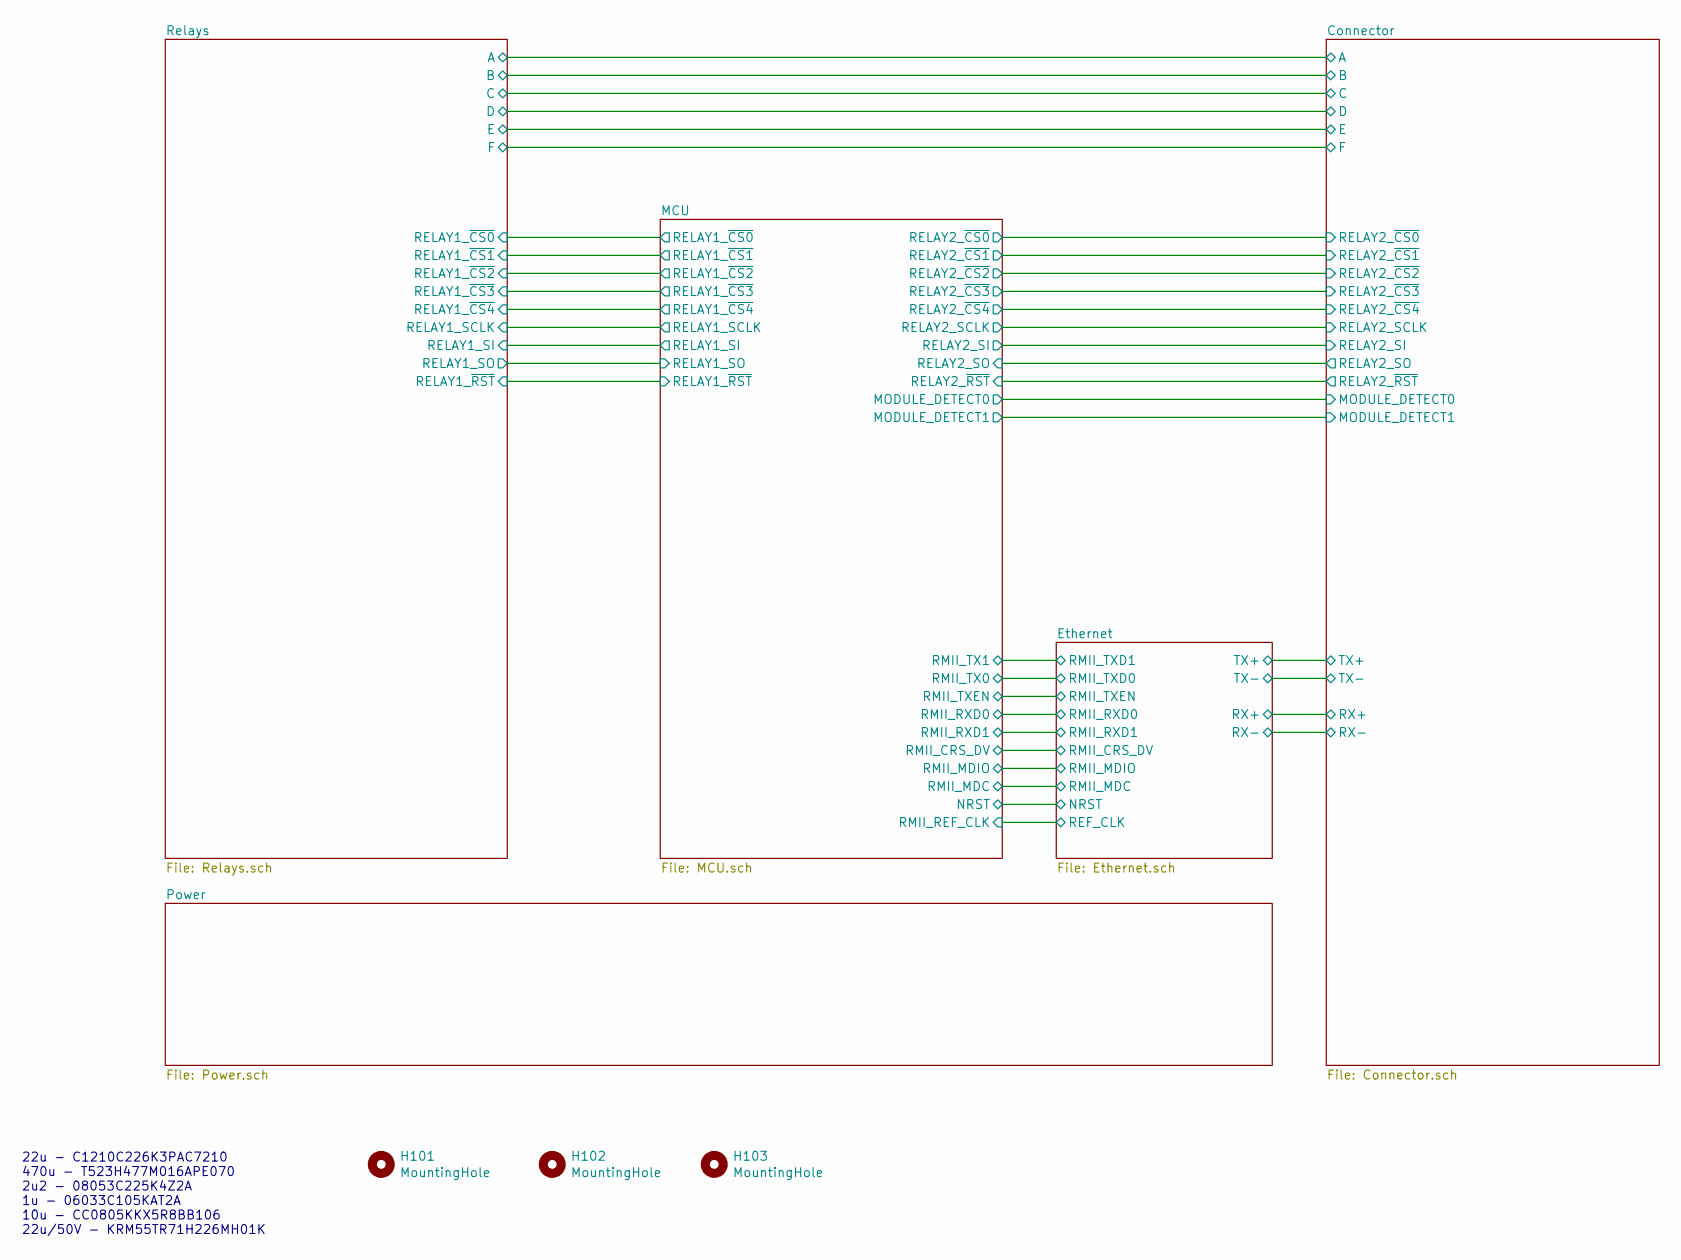
[picture p27: schematic ETH6C20MUX.sch, Main]

Parts:
H101, H102, H103: MountingHole; MountingHole_2.7mm_M2.5_DIN965_Pad

Notes on the sheet:
22u - C1210C226K3PAC7210 470u - T523H477M016APE070 2u2 - 08053C225K4Z2A 1u - 06033C105KAT2A 10u - CC0805KKX5R8BB106 22u/50V - KRM55TR71H226MH01K

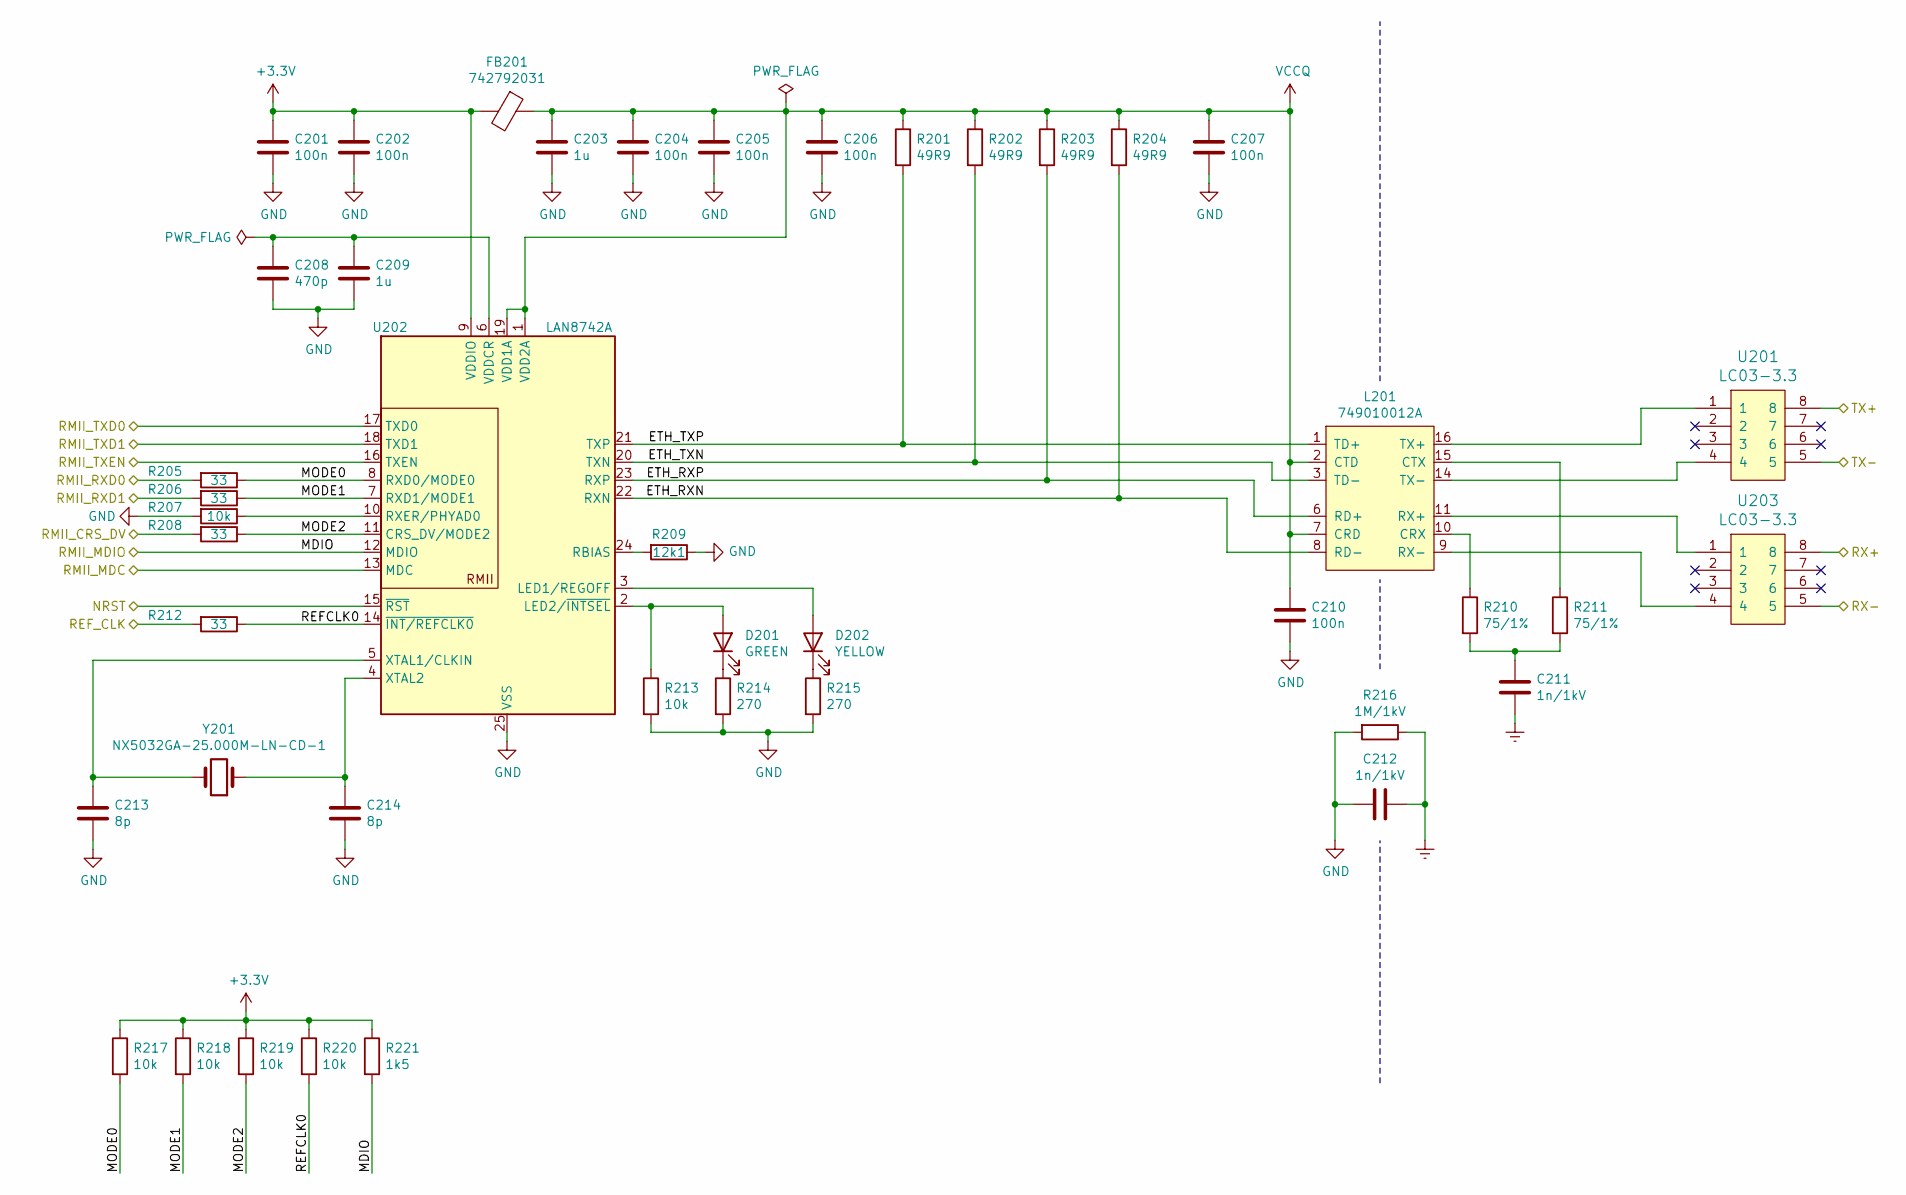
[picture p28: schematic Ethernet.sch]

Parts:
C201, C202, C204, C205, C206, C207, C210: 100n; C_0603_1608Metric_Pad1.08x0.95mm_HandSolder
C203, C209: 1u; C_0603_1608Metric_Pad1.08x0.95mm_HandSolder
C208: 470p; C_0603_1608Metric_Pad1.08x0.95mm_HandSolder
C211, C212: 1n/1kV; C_1206_3216Metric_Pad1.42x1.75mm_HandSolder
C213, C214: 8p; C_0603_1608Metric_Pad1.08x0.95mm_HandSolder
D201: GREEN; LED_0603_1608Metric_Pad1.05x0.95mm_HandSolder
D202: YELLOW; LED_0603_1608Metric_Pad1.05x0.95mm_HandSolder
FB201: 742792031; R_0805_2012Metric_Pad1.15x1.40mm_HandSolder
L201: 749010012A
R201, R202, R203, R204: 49R9; R_0603_1608Metric_Pad0.98x0.95mm_HandSolder
R205, R206, R208, R212: 33; R_0603_1608Metric_Pad0.98x0.95mm_HandSolder
R207, R213, R217, R218, R219, R220: 10k; R_0603_1608Metric_Pad0.98x0.95mm_HandSolder
R209: 12k1; R_0603_1608Metric_Pad0.98x0.95mm_HandSolder
R210, R211: 75/1%; R_0603_1608Metric_Pad0.98x0.95mm_HandSolder
R214, R215: 270; R_0603_1608Metric_Pad0.98x0.95mm_HandSolder
R216: 1M/1kV; R_1206_3216Metric_Pad1.30x1.75mm_HandSolder
R221: 1k5; R_0603_1608Metric_Pad0.98x0.95mm_HandSolder
U201, U203: LC03-3.3; SO8E
U202: LAN8742A; QFN-24-1EP_4x4mm_P0.5mm_EP2.6x2.6mm_ThermalVias
Y201: NX5032GA-25.000M-LN-CD-1; NX5032GA

Connections:
+3V3: C201.1, C202.1, FB201.2, R217.1, R218.1, R219.1, R220.1, R221.1, U202.9 (VDDIO); also elsewhere on the board
/Connector/RX+: U203.8; also elsewhere on the board
/Connector/RX-: U203.5; also elsewhere on the board
/Connector/TX+: U201.8; also elsewhere on the board
/Connector/TX-: U201.5; also elsewhere on the board
/Ethernet/ETH_RXN: L201.8 (RD-), R204.2, U202.22 (RXN)
/Ethernet/ETH_RXP: L201.6 (RD+), R203.2, U202.23 (RXP)
/Ethernet/ETH_TXN: L201.3 (TD-), R202.2, U202.20 (TXN)
/Ethernet/ETH_TXP: L201.1 (TD+), R201.2, U202.21 (TXP)
/Ethernet/MODE0: R205.1, R217.2, U202.8 (RXD0/MODE0)
/Ethernet/MODE1: R206.1, R218.2, U202.7 (RXD1/MODE1)
/Ethernet/MODE2: R208.1, R219.2, U202.11 (CRS_DV/MODE2)
/Ethernet/NRST: U202.15 (~RST); also elsewhere on the board
/Ethernet/REFCLK0: R212.1, R220.2, U202.14 (~INT/REFCLK0)
/Ethernet/REF_CLK: R212.2; also elsewhere on the board
/Ethernet/RMII_CRS_DV: R208.2; also elsewhere on the board
/Ethernet/RMII_MDC: U202.13 (MDC); also elsewhere on the board
/Ethernet/RMII_MDIO: R221.2, U202.12 (MDIO); also elsewhere on the board
/Ethernet/RMII_RXD0: R205.2; also elsewhere on the board
/Ethernet/RMII_RXD1: R206.2; also elsewhere on the board
/Ethernet/RMII_TXEN: U202.16 (TXEN); also elsewhere on the board
/MCU/RMII_TX0: U202.17 (TXD0); also elsewhere on the board
/MCU/RMII_TX1: U202.18 (TXD1); also elsewhere on the board
Earth: C211.2, C212.1, R216.1; also elsewhere on the board
GND: C201.2, C202.2, C203.2, C204.2, C205.2, C206.2, C207.2, C208.2, C209.2, C210.2, C212.2, C213.2, C214.2, R207.2, R209.1, R213.2, R214.2, R215.2, R216.2, U202.25 (VSS); also elsewhere on the board
unnamed: C208.1, C209.1, U202.6 (VDDCR)
unnamed: C211.1, R210.2, R211.2
unnamed: C213.1, U202.5 (XTAL1/CLKIN), Y201.2
unnamed: C214.1, U202.4 (XTAL2), Y201.1
unnamed: D201.1 (K), R214.1
unnamed: D201.2 (A), R213.1, U202.2 (LED2/~INTSEL)
unnamed: D202.1 (K), R215.1
unnamed: D202.2 (A), U202.3 (LED1/REGOFF)
unnamed: L201.9 (RX-), U203.4
unnamed: L201.10 (CRX), R210.1
unnamed: L201.11 (RX+), U203.1
unnamed: L201.14 (TX-), U201.4
unnamed: L201.15 (CTX), R211.1
unnamed: L201.16 (TX+), U201.1
unnamed: R207.1, U202.10 (RXER/PHYAD0)
unnamed: R209.2, U202.24 (RBIAS)
VCCQ: C203.1, C204.1, C205.1, C206.1, C207.1, C210.1, FB201.1, L201.2 (CTD), L201.7 (CRD), R201.1, R202.1, R203.1, R204.1, U202.1 (VDD2A), U202.19 (VDD1A)
