BehrensG/ETH6C12MUX/hardware/project/ETH6C20MUX/ETH6C20MUX.kicad_pcb

## KiCad design hardware/project/ETH6C20MUX/ETH6C20MUX.kicad_pcb (continued)

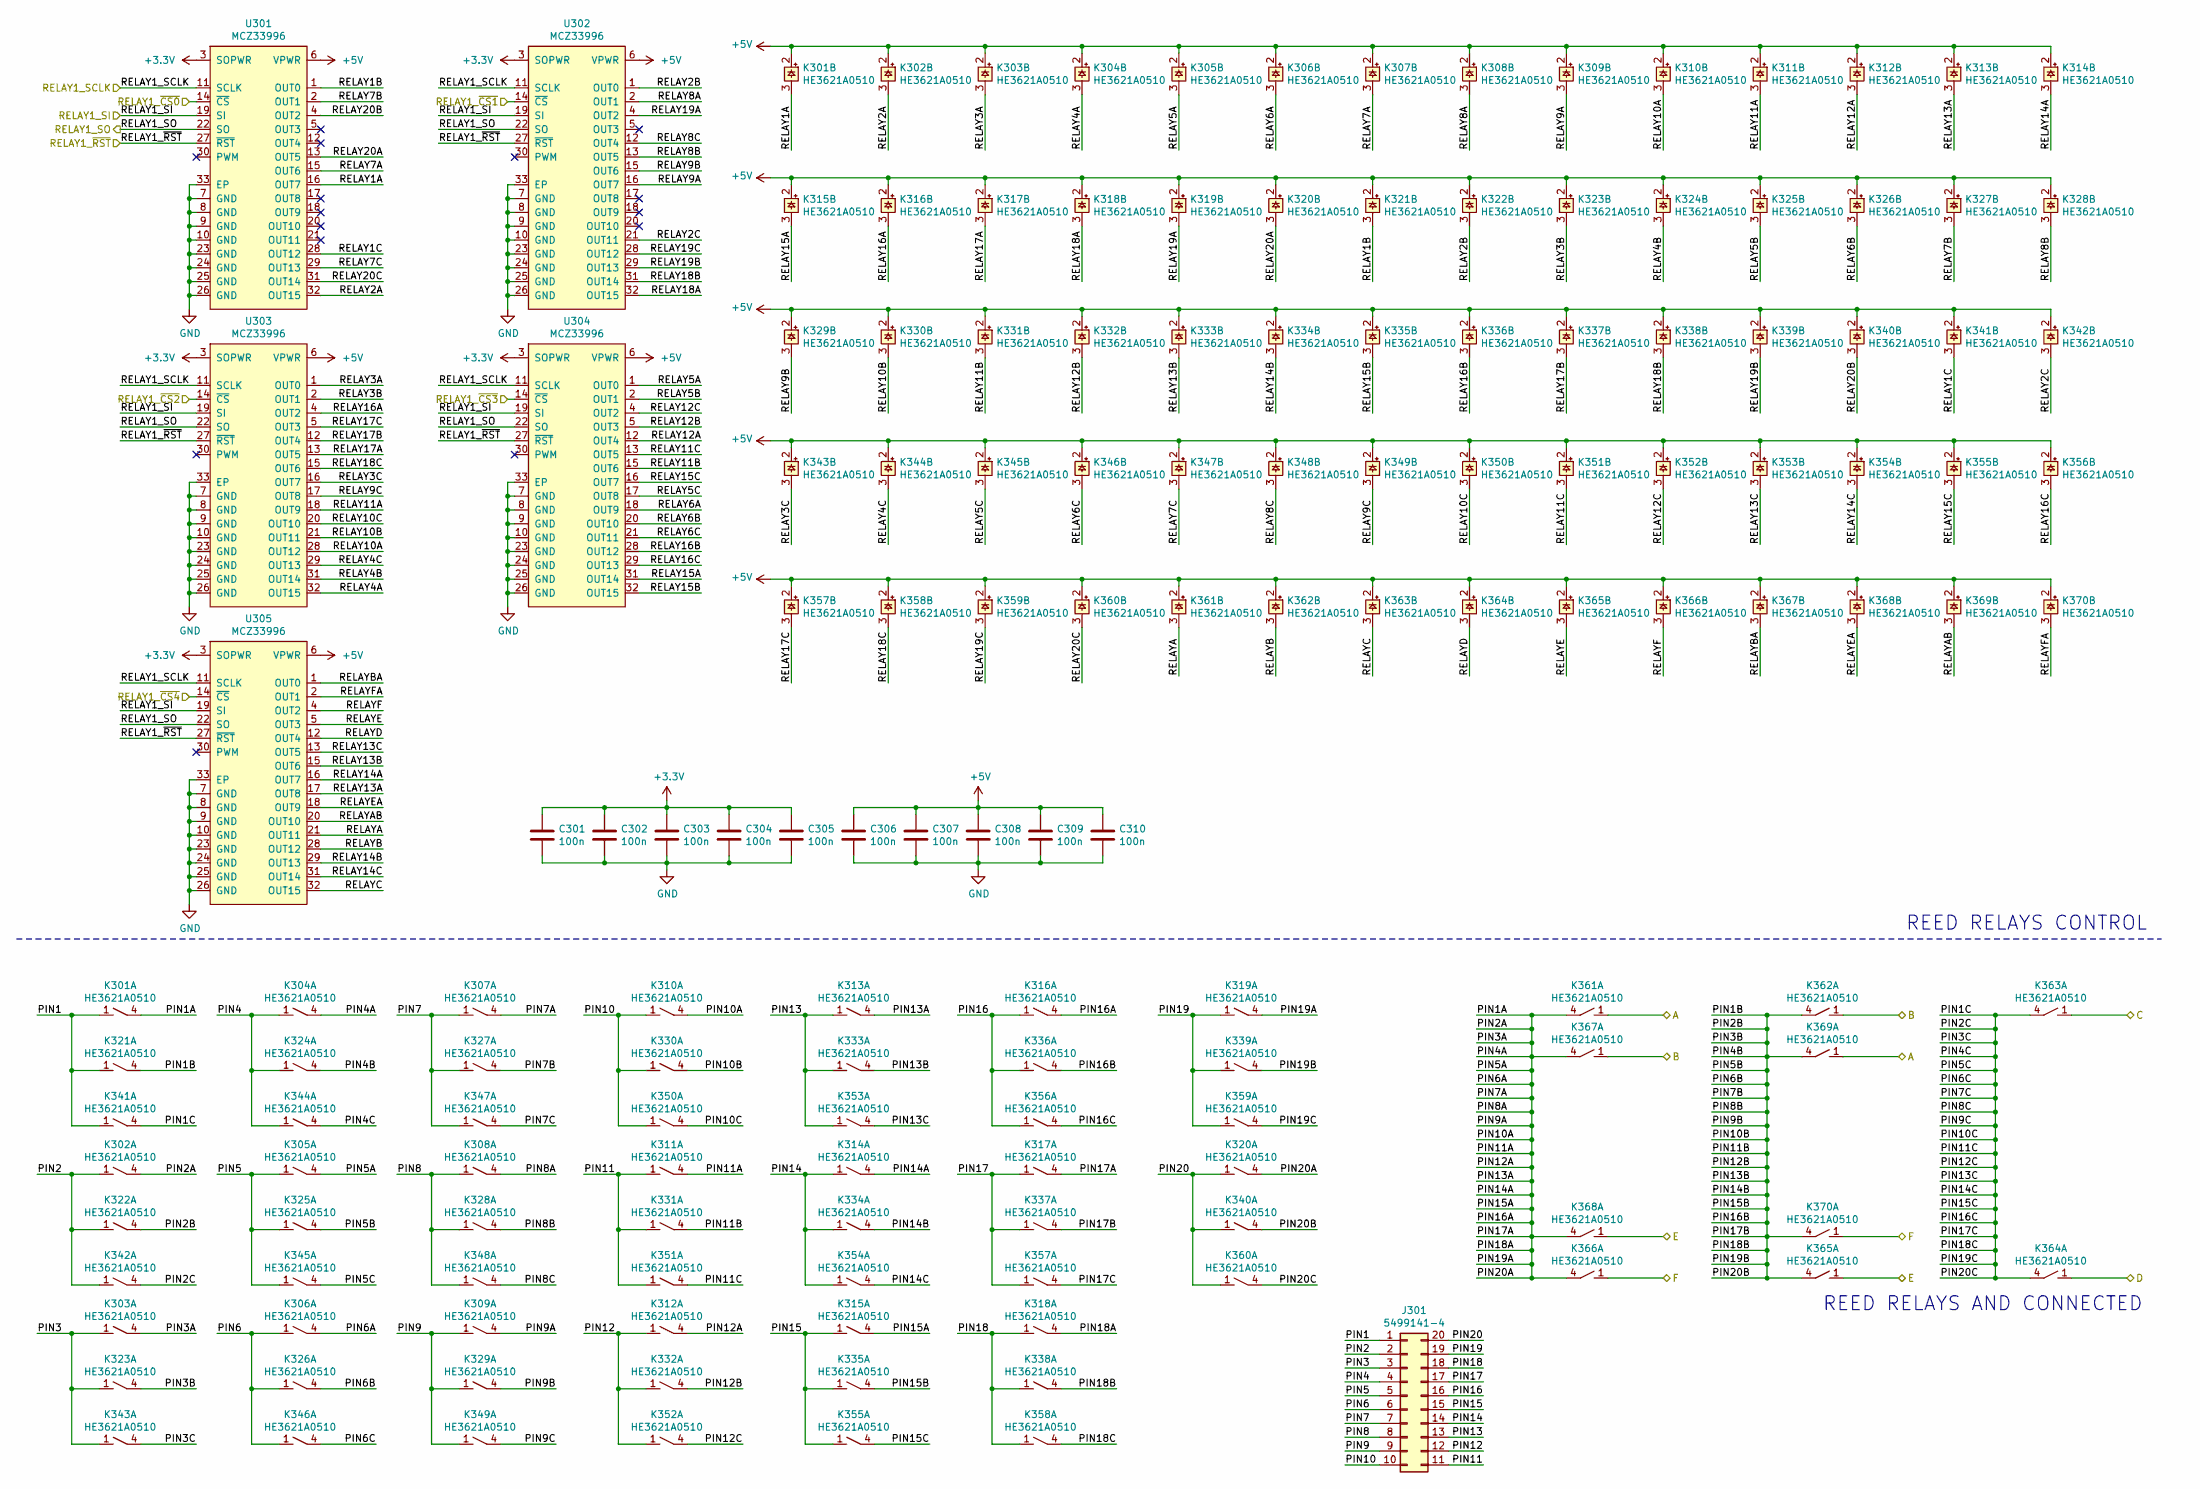
[picture p29: schematic Relays.sch]

Parts:
C301, C302, C303, C304, C305, C306, C307, C308, C309, C310: 100n; C_0603_1608Metric_Pad1.08x0.95mm_HandSolder
J301: 5499141-4; IDC-Header_2x10_P2.54mm_Horizontal_Lock
K301, K302, K303, K304, K305, K306, K307, K308, K309, K310, K311, K312, K313, K314, K315, K316, K317, K318, K319, K320, K321, K322, K323, K324, K325, K326, K327, K328, K329, K330, K331, K332, K333, K334, K335, K336, K337, K338, K339, K340, K341, K342, K343, K344, K345, K346, K347, K348, K349, K350, K351, K352, K353, K354, K355, K356, K357, K358, K359, K360, K361, K362, K363, K364, K365, K366, K367, K368, K369, K370: HE3621A0510; HE360_x-5050462-8
U301, U302, U303, U304, U305: MCZ33996; HSOP-32-1EP_7.5x11.0mm_P0.65mm_ThermalVias

Connections:
+3V3: C301.1, C302.1, C303.1, C304.1, C305.1, U301.3 (SOPWR), U302.3 (SOPWR), U303.3 (SOPWR), U304.3 (SOPWR), U305.3 (SOPWR); also elsewhere on the board
+5V: C306.1, C307.1, C308.1, C309.1, C310.1, K301.2, K302.2, K303.2, K304.2, K305.2, K306.2, K307.2, K308.2, K309.2, K310.2, K311.2, K312.2, K313.2, K314.2, K315.2, K316.2, K317.2, K318.2, K319.2, K320.2, K321.2, K322.2, K323.2, K324.2, K325.2, K326.2, K327.2, K328.2, K329.2, K330.2, K331.2, K332.2, K333.2, K334.2, K335.2, K336.2, K337.2, K338.2, K339.2, K340.2, K341.2, K342.2, K343.2, K344.2, K345.2, K346.2, K347.2, K348.2, K349.2, K350.2, K351.2, K352.2, K353.2, K354.2, K355.2, K356.2, K357.2, K358.2, K359.2, K360.2, K361.2, K362.2, K363.2, K364.2, K365.2, K366.2, K367.2, K368.2, K369.2, K370.2, U301.6 (VPWR), U302.6 (VPWR), U303.6 (VPWR), U304.6 (VPWR), U305.6 (VPWR); also elsewhere on the board
/Connector/A: K361.1, K369.1; also elsewhere on the board
/Connector/B: K362.1, K367.1; also elsewhere on the board
/Connector/C: K363.1; also elsewhere on the board
/Connector/D: K364.1; also elsewhere on the board
/Connector/E: K365.1, K368.1; also elsewhere on the board
/Connector/F: K366.1, K370.1; also elsewhere on the board
/MCU/RELAY1_SCLK: U301.11 (SCLK), U302.11 (SCLK), U303.11 (SCLK), U304.11 (SCLK), U305.11 (SCLK); also elsewhere on the board
/MCU/RELAY1_SI: U301.19 (SI), U302.19 (SI), U303.19 (SI), U304.19 (SI), U305.19 (SI); also elsewhere on the board
/MCU/RELAY1_SO: U301.22 (SO), U302.22 (SO), U303.22 (SO), U304.22 (SO), U305.22 (SO); also elsewhere on the board
/MCU/RELAY1_~CS0: U301.14 (~CS); also elsewhere on the board
/MCU/RELAY1_~CS1: U302.14 (~CS); also elsewhere on the board
/MCU/RELAY1_~CS2: U303.14 (~CS); also elsewhere on the board
/MCU/RELAY1_~CS3: U304.14 (~CS); also elsewhere on the board
/MCU/RELAY1_~CS4: U305.14 (~CS); also elsewhere on the board
/MCU/RELAY1_~RST: U301.27 (~RST), U302.27 (~RST), U303.27 (~RST), U304.27 (~RST), U305.27 (~RST); also elsewhere on the board
/Relays/PIN1: J301.1, K301.1, K321.1, K341.1
/Relays/PIN2: J301.2, K302.1, K322.1, K342.1
/Relays/PIN3: J301.3, K303.1, K323.1, K343.1
/Relays/PIN4: J301.4, K304.1, K324.1, K344.1
/Relays/PIN5: J301.5, K305.1, K325.1, K345.1
/Relays/PIN6: J301.6, K306.1, K326.1, K346.1
/Relays/PIN7: J301.7, K307.1, K327.1, K347.1
/Relays/PIN8: J301.8, K308.1, K328.1, K348.1
/Relays/PIN9: J301.9, K309.1, K329.1, K349.1
/Relays/PIN10: J301.10, K310.1, K330.1, K350.1
/Relays/PIN10A: K301.4, K302.4, K303.4, K304.4, K305.4, K306.4, K307.4, K308.4, K309.4, K310.4, K311.4, K312.4, K313.4, K314.4, K315.4, K316.4, K317.4, K318.4, K319.4, K320.4, K361.4, K366.4, K367.4, K368.4
/Relays/PIN10B: K321.4, K322.4, K323.4, K324.4, K325.4, K326.4, K327.4, K328.4, K329.4, K330.4, K331.4, K332.4, K333.4, K334.4, K335.4, K336.4, K337.4, K338.4, K339.4, K340.4, K362.4, K365.4, K369.4, K370.4
/Relays/PIN10C: K341.4, K342.4, K343.4, K344.4, K345.4, K346.4, K347.4, K348.4, K349.4, K350.4, K351.4, K352.4, K353.4, K354.4, K355.4, K356.4, K357.4, K358.4, K359.4, K360.4, K363.4, K364.4
/Relays/PIN11: J301.11, K311.1, K331.1, K351.1
/Relays/PIN12: J301.12, K312.1, K332.1, K352.1
/Relays/PIN13: J301.13, K313.1, K333.1, K353.1
/Relays/PIN14: J301.14, K314.1, K334.1, K354.1
/Relays/PIN15: J301.15, K315.1, K335.1, K355.1
/Relays/PIN16: J301.16, K316.1, K336.1, K356.1
/Relays/PIN17: J301.17, K317.1, K337.1, K357.1
/Relays/PIN18: J301.18, K318.1, K338.1, K358.1
/Relays/PIN19: J301.19, K319.1, K339.1, K359.1
/Relays/PIN20: J301.20, K320.1, K340.1, K360.1
/Relays/RELAY1A: K301.3, U301.16 (OUT7)
/Relays/RELAY1B: K321.3, U301.1 (OUT0)
/Relays/RELAY1C: K341.3, U301.28 (OUT12)
/Relays/RELAY2A: K302.3, U301.32 (OUT15)
/Relays/RELAY2B: K322.3, U302.1 (OUT0)
/Relays/RELAY2C: K342.3, U302.21 (OUT11)
/Relays/RELAY3A: K303.3, U303.1 (OUT0)
/Relays/RELAY3B: K323.3, U303.2 (OUT1)
/Relays/RELAY3C: K343.3, U303.16 (OUT7)
/Relays/RELAY4A: K304.3, U303.32 (OUT15)
/Relays/RELAY4B: K324.3, U303.31 (OUT14)
/Relays/RELAY4C: K344.3, U303.29 (OUT13)
/Relays/RELAY5A: K305.3, U304.1 (OUT0)
/Relays/RELAY5B: K325.3, U304.2 (OUT1)
/Relays/RELAY5C: K345.3, U304.17 (OUT8)
/Relays/RELAY6A: K306.3, U304.18 (OUT9)
/Relays/RELAY6B: K326.3, U304.20 (OUT10)
/Relays/RELAY6C: K346.3, U304.21 (OUT11)
/Relays/RELAY7A: K307.3, U301.15 (OUT6)
/Relays/RELAY7B: K327.3, U301.2 (OUT1)
/Relays/RELAY7C: K347.3, U301.29 (OUT13)
/Relays/RELAY8A: K308.3, U302.2 (OUT1)
/Relays/RELAY8B: K328.3, U302.13 (OUT5)
/Relays/RELAY8C: K348.3, U302.12 (OUT4)
/Relays/RELAY9A: K309.3, U302.16 (OUT7)
/Relays/RELAY9B: K329.3, U302.15 (OUT6)
/Relays/RELAY9C: K349.3, U303.17 (OUT8)
/Relays/RELAY10A: K310.3, U303.28 (OUT12)
/Relays/RELAY10B: K330.3, U303.21 (OUT11)
/Relays/RELAY10C: K350.3, U303.20 (OUT10)
/Relays/RELAY11A: K311.3, U303.18 (OUT9)
/Relays/RELAY11B: K331.3, U304.15 (OUT6)
/Relays/RELAY11C: K351.3, U304.13 (OUT5)
/Relays/RELAY12A: K312.3, U304.12 (OUT4)
/Relays/RELAY12B: K332.3, U304.5 (OUT3)
/Relays/RELAY12C: K352.3, U304.4 (OUT2)
/Relays/RELAY13A: K313.3, U305.17 (OUT8)
/Relays/RELAY13B: K333.3, U305.15 (OUT6)
/Relays/RELAY13C: K353.3, U305.13 (OUT5)
/Relays/RELAY14A: K314.3, U305.16 (OUT7)
/Relays/RELAY14B: K334.3, U305.29 (OUT13)
/Relays/RELAY14C: K354.3, U305.31 (OUT14)
/Relays/RELAY15A: K315.3, U304.31 (OUT14)
/Relays/RELAY15B: K335.3, U304.32 (OUT15)
/Relays/RELAY15C: K355.3, U304.16 (OUT7)
/Relays/RELAY16A: K316.3, U303.4 (OUT2)
/Relays/RELAY16B: K336.3, U304.28 (OUT12)
/Relays/RELAY16C: K356.3, U304.29 (OUT13)
/Relays/RELAY17A: K317.3, U303.13 (OUT5)
/Relays/RELAY17B: K337.3, U303.12 (OUT4)
/Relays/RELAY17C: K357.3, U303.5 (OUT3)
/Relays/RELAY18A: K318.3, U302.32 (OUT15)
/Relays/RELAY18B: K338.3, U302.31 (OUT14)
/Relays/RELAY18C: K358.3, U303.15 (OUT6)
/Relays/RELAY19A: K319.3, U302.4 (OUT2)
/Relays/RELAY19B: K339.3, U302.29 (OUT13)
/Relays/RELAY19C: K359.3, U302.28 (OUT12)
/Relays/RELAY20A: K320.3, U301.13 (OUT5)
/Relays/RELAY20B: K340.3, U301.4 (OUT2)
/Relays/RELAY20C: K360.3, U301.31 (OUT14)
/Relays/RELAYA: K361.3, U305.21 (OUT11)
/Relays/RELAYAB: K369.3, U305.20 (OUT10)
/Relays/RELAYB: K362.3, U305.28 (OUT12)
/Relays/RELAYBA: K367.3, U305.1 (OUT0)
/Relays/RELAYC: K363.3, U305.32 (OUT15)
/Relays/RELAYD: K364.3, U305.12 (OUT4)
/Relays/RELAYE: K365.3, U305.5 (OUT3)
/Relays/RELAYEA: K368.3, U305.18 (OUT9)
/Relays/RELAYF: K366.3, U305.4 (OUT2)
/Relays/RELAYFA: K370.3, U305.2 (OUT1)
GND: C301.2, C302.2, C303.2, C304.2, C305.2, C306.2, C307.2, C308.2, C309.2, C310.2, U301.7 (GND), U301.8 (GND), U301.9 (GND), U301.10 (GND), U301.23 (GND), U301.24 (GND), U301.25 (GND), U301.26 (GND), U301.33 (EP), U302.7 (GND), U302.8 (GND), U302.9 (GND), U302.10 (GND), U302.23 (GND), U302.24 (GND), U302.25 (GND), U302.26 (GND), U302.33 (EP), U303.7 (GND), U303.8 (GND), U303.9 (GND), U303.10 (GND), U303.23 (GND), U303.24 (GND), U303.25 (GND), U303.26 (GND), U303.33 (EP), U304.7 (GND), U304.8 (GND), U304.9 (GND), U304.10 (GND), U304.23 (GND), U304.24 (GND), U304.25 (GND), U304.26 (GND), U304.33 (EP), U305.7 (GND), U305.8 (GND), U305.9 (GND), U305.10 (GND), U305.23 (GND), U305.24 (GND), U305.25 (GND), U305.26 (GND), U305.33 (EP); also elsewhere on the board

Notes on the sheet:
REED RELAYS AND CONNECTED
REED RELAYS CONTROL

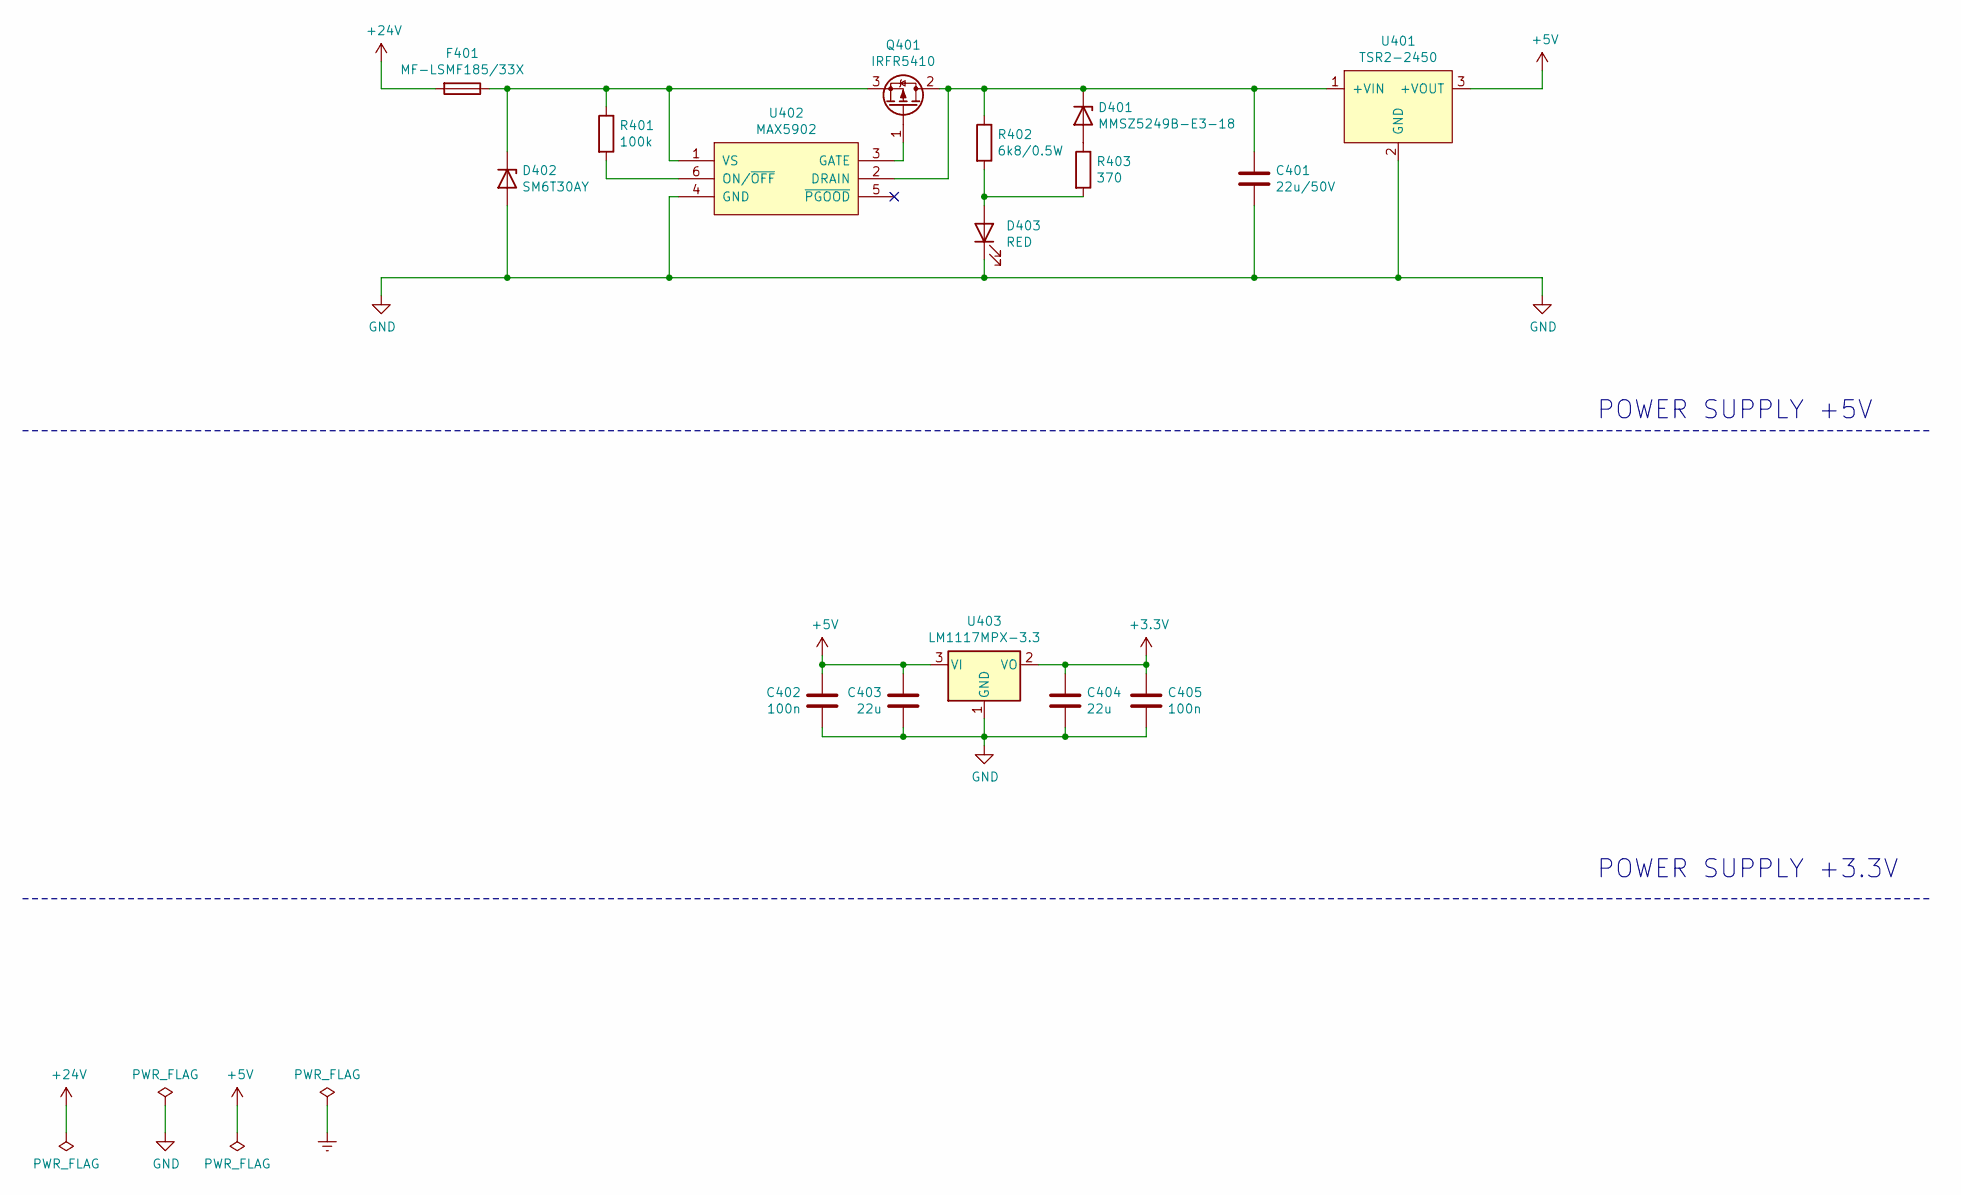
[picture p30: schematic Power.sch]

Parts:
C401: 22u/50V; C_2220_5650Metric_Pad1.97x5.40mm_HandSolder
C402, C405: 100n; C_0603_1608Metric_Pad1.08x0.95mm_HandSolder
C403, C404: 22u; C_1210_3225Metric_Pad1.42x2.65mm_HandSolder
D401: MMSZ5249B-E3-18; D_SOD-123
D402: SM6T30AY; DO_214AA_REV
D403: RED; LED_0603_1608Metric_Pad1.05x0.95mm_HandSolder
F401: MF-LSMF185/33X; Fuse_SMD2920
Q401: IRFR5410; TO-252-2_Rectifier
R401: 100k; R_0603_1608Metric_Pad0.98x0.95mm_HandSolder
R402: 6k8/0.5W; R_0603_1608Metric_Pad0.98x0.95mm_HandSolder
R403: 370; R_0603_1608Metric_Pad0.98x0.95mm_HandSolder
U401: TSR2-2450; TSR2
U402: MAX5902; SOT-23-6_Handsoldering
U403: LM1117MPX-3.3; SOT-223-3_TabPin2

Connections:
+3V3: C404.1, C405.1, U403.2 (VO); also elsewhere on the board
+5V: C402.1, C403.1, U401.3 (+VOUT), U403.3 (VI); also elsewhere on the board
+24V: F401.2; also elsewhere on the board
GND: C401.2, C402.2, C403.2, C404.2, C405.2, D402.2 (A), D403.1 (K), U401.2 (GND), U402.4 (GND), U403.1 (GND); also elsewhere on the board
unnamed: C401.1, D401.1 (K), Q401.2 (D), R402.1, U401.1 (+VIN), U402.2 (DRAIN)
unnamed: D401.2 (A), R403.1
unnamed: D402.1 (K), F401.1, Q401.3 (S), R401.1, U402.1 (VS)
unnamed: D403.2 (A), R402.2, R403.2
unnamed: Q401.1 (G), U402.3 (GATE)
unnamed: R401.2, U402.6 (ON/~OFF)

Notes on the sheet:
POWER SUPPLY +5V
POWER SUPPLY +3.3V

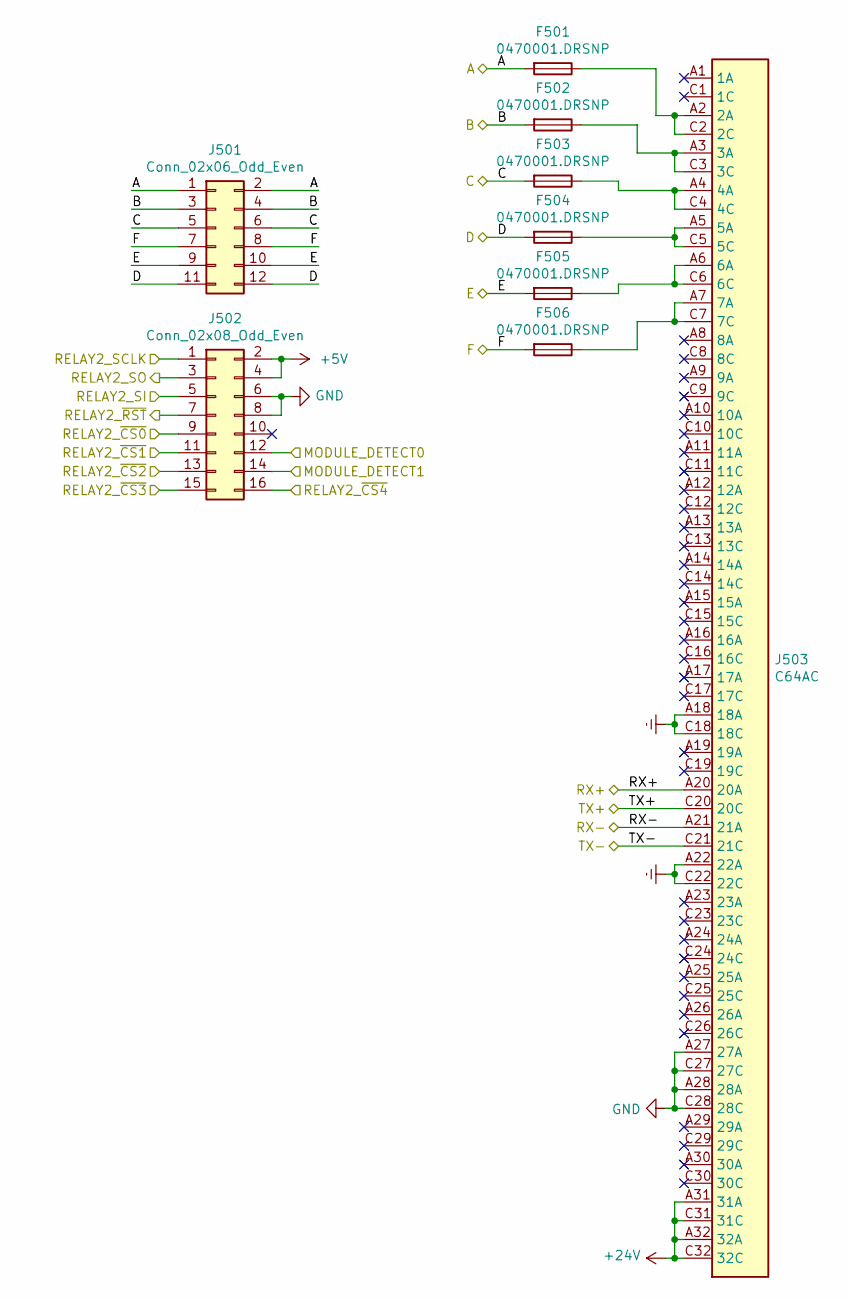
[picture p31: schematic Connector.sch]

Parts:
F501, F502, F503, F504, F505, F506: 0470001.DRSNP; 0470
J501: Conn_02x06_Odd_Even; PinSocket_2x06_P2.54mm_Vertical
J502: Conn_02x08_Odd_Even; PinSocket_2x08_P2.54mm_Vertical
J503: C64AC; Socket_DIN41612-CaseC1-AC-Male-64Pin-2rows

Connections:
+5V: J502.2, J502.4; also elsewhere on the board
+24V: J503.A31 (31A), J503.A32 (32A), J503.C31 (31C), J503.C32 (32C); also elsewhere on the board
/Connector/A: F501.2, J501.1, J501.2; also elsewhere on the board
/Connector/B: F502.2, J501.3, J501.4; also elsewhere on the board
/Connector/C: F503.2, J501.5, J501.6; also elsewhere on the board
/Connector/D: F504.2, J501.11, J501.12; also elsewhere on the board
/Connector/E: F505.2, J501.9, J501.10; also elsewhere on the board
/Connector/F: F506.2, J501.7, J501.8; also elsewhere on the board
/Connector/MODULE_DETECT0: J502.12; also elsewhere on the board
/Connector/MODULE_DETECT1: J502.14; also elsewhere on the board
/Connector/RELAY2_SCLK: J502.1; also elsewhere on the board
/Connector/RELAY2_SI: J502.5; also elsewhere on the board
/Connector/RELAY2_SO: J502.3; also elsewhere on the board
/Connector/RELAY2_~CS0: J502.9; also elsewhere on the board
/Connector/RELAY2_~CS1: J502.11; also elsewhere on the board
/Connector/RELAY2_~CS2: J502.13; also elsewhere on the board
/Connector/RELAY2_~CS3: J502.15; also elsewhere on the board
/Connector/RELAY2_~CS4: J502.16; also elsewhere on the board
/Connector/RELAY2_~RST: J502.7; also elsewhere on the board
/Connector/RX+: J503.A20 (20A); also elsewhere on the board
/Connector/RX-: J503.A21 (21A); also elsewhere on the board
/Connector/TX+: J503.C20 (20C); also elsewhere on the board
/Connector/TX-: J503.C21 (21C); also elsewhere on the board
Earth: J503.A18 (18A), J503.A22 (22A), J503.C18 (18C), J503.C22 (22C); also elsewhere on the board
GND: J502.6, J502.8, J503.A27 (27A), J503.A28 (28A), J503.C27 (27C), J503.C28 (28C); also elsewhere on the board
unnamed: F501.1, J503.A2 (2A), J503.C2 (2C)
unnamed: F502.1, J503.A3 (3A), J503.C3 (3C)
unnamed: F503.1, J503.A4 (4A), J503.C4 (4C)
unnamed: F504.1, J503.A5 (5A), J503.C5 (5C)
unnamed: F505.1, J503.A6 (6A), J503.C6 (6C)
unnamed: F506.1, J503.A7 (7A), J503.C7 (7C)

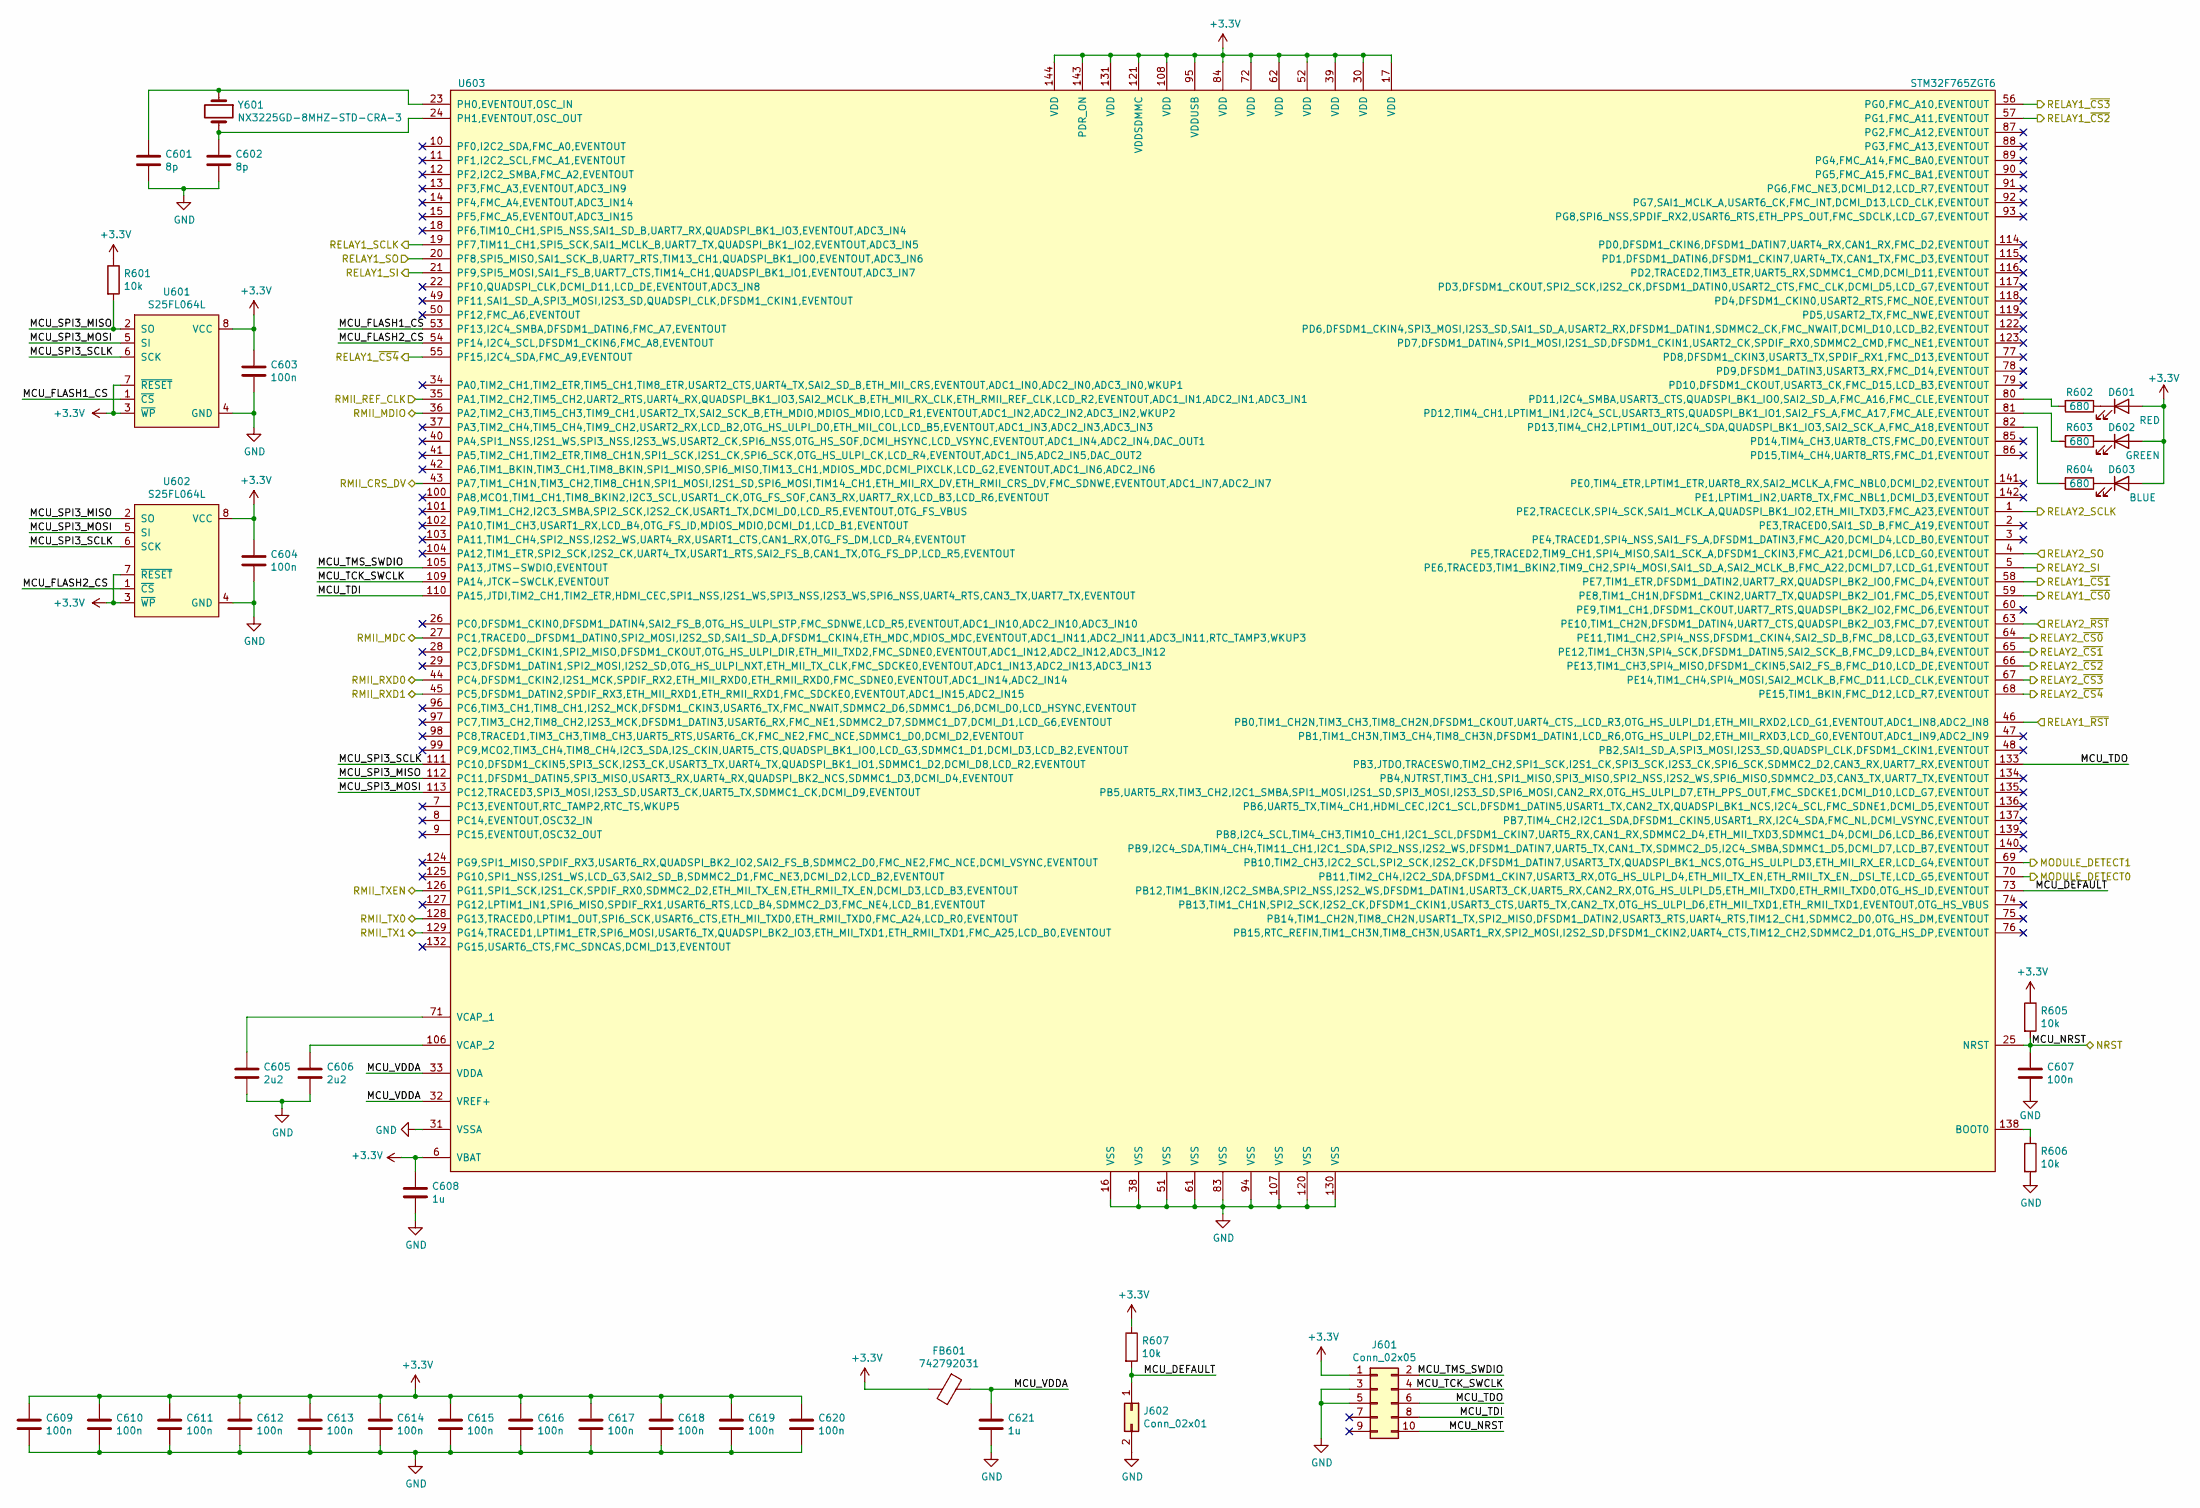
[picture p32: schematic MCU.sch]

Parts:
C601, C602: 8p; C_0603_1608Metric_Pad1.08x0.95mm_HandSolder
C603, C604, C607, C609, C610, C611, C612, C613, C614, C615, C616, C617, C618, C619, C620: 100n; C_0603_1608Metric_Pad1.08x0.95mm_HandSolder
C605, C606: 2u2; C_0805_2012Metric_Pad1.15x1.40mm_HandSolder
C608, C621: 1u; C_0603_1608Metric_Pad1.08x0.95mm_HandSolder
D601: RED; LED_Dialight_591
D602: GREEN; LED_Dialight_591
D603: BLUE; LED_Dialight_591
FB601: 742792031; R_0805_2012Metric_Pad1.15x1.40mm_HandSolder
J601: Conn_02x05; PinHeader_2x05_P1.27mm_Vertical
J602: Conn_02x01; PinHeader_1x02_P2.54mm_Vertical
R601, R605, R606, R607: 10k; R_0603_1608Metric_Pad0.98x0.95mm_HandSolder
R602, R603, R604: 680; R_0603_1608Metric_Pad0.98x0.95mm_HandSolder
U601, U602: S25FL064L; SOIC-8_5.23x5.23mm_P1.27mm
U603: STM32F765ZGT6; TQFP-144_20x20mm_P0.5mm
Y601: NX3225GD-8MHZ-STD-CRA-3; NX3225GD

Connections:
+3V3: C603.1, C604.1, C608.1, C609.1, C610.1, C611.1, C612.1, C613.1, C614.1, C615.1, C616.1, C617.1, C618.1, C619.1, C620.1, D601.2 (A), D602.2 (A), D603.2 (A), FB601.2, J601.1, R601.1, R605.1, R607.1, U601.3 (~WP), U601.7 (~RESET), U601.8 (VCC), U602.3 (~WP), U602.7 (~RESET), U602.8 (VCC), U603.6 (VBAT), U603.17 (VDD), U603.30 (VDD), U603.39 (VDD), U603.52 (VDD), U603.62 (VDD), U603.72 (VDD), U603.84 (VDD), U603.95 (VDDUSB), U603.108 (VDD), U603.121 (VDDSDMMC), U603.131 (VDD), U603.143 (PDR_ON), U603.144 (VDD); also elsewhere on the board
/Connector/MODULE_DETECT0: U603.70 (PB11,TIM2_CH4,I2C2_SDA,DFSDM1_CKIN7,USA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); also elsewhere on the board
/Connector/MODULE_DETECT1: U603.69 (PB10,TIM2_CH3,I2C2_SCL,SPI2_SCK,I2S2_CK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); also elsewhere on the board
/Connector/RELAY2_SCLK: U603.1 (PE2,TRACECLK,SPI4_SCK,SAI1_MCLK_A,QUADS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); also elsewhere on the board
/Connector/RELAY2_SI: U603.5 (PE6,TRACED3,TIM1_BKIN2,TIM9_CH2,SPI4_MO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); also elsewhere on the board
/Connector/RELAY2_SO: U603.4 (PE5,TRACED2,TIM9_CH1,SPI4_MISO,SAI1_SCK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); also elsewhere on the board
/Connector/RELAY2_~CS0: U603.64 (PE11,TIM1_CH2,SPI4_NSS,DFSDM1_CKIN4,SAI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); also elsewhere on the board
/Connector/RELAY2_~CS1: U603.65 (PE12,TIM1_CH3N,SPI4_SCK,DFSDM1_DATIN5,S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); also elsewhere on the board
/Connector/RELAY2_~CS2: U603.66 (PE13,TIM1_CH3,SPI4_MISO,DFSDM1_CKIN5,SA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); also elsewhere on the board
/Connector/RELAY2_~CS3: U603.67 (PE14,TIM1_CH4,SPI4_MOSI,SAI2_MCLK_B,FMC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); also elsewhere on the board
/Connector/RELAY2_~CS4: U603.68 (PE15,TIM1_BKIN,FMC_D12,LCD_R7,EVENTOUT); also elsewhere on the board
/Connector/RELAY2_~RST: U603.63 (PE10,TIM1_CH2N,DFSDM1_DATIN4,UART7_CTS,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); also elsewhere on the board
/Ethernet/NRST: C607.1, J601.10, R605.2, U603.25 (NRST); also elsewhere on the board
/Ethernet/REF_CLK: U603.35 (PA1,TIM2_CH2,TIM5_CH2,UART2_RTS,UART4_R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); also elsewhere on the board
/Ethernet/RMII_CRS_DV: U603.43 (PA7,TIM1_CH1N,TIM3_CH2,TIM8_CH1N,SPI1_M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); also elsewhere on the board
/Ethernet/RMII_MDC: U603.27 (PC1,TRACED0,_DFSDM1_DATIN0,SPI2_MOSI,I2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); also elsewhere on the board
/Ethernet/RMII_MDIO: U603.36 (PA2,TIM2_CH3,TIM5_CH3,TIM9_CH1,USART2_T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); also elsewhere on the board
/Ethernet/RMII_RXD0: U603.44 (PC4,DFSDM1_CKIN2,I2S1_MCK,SPDIF_RX2,ETH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); also elsewhere on the board
/Ethernet/RMII_RXD1: U603.45 (PC5,DFSDM1_DATIN2,SPDIF_RX3,ETH_MII_RXD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); also elsewhere on the board
/Ethernet/RMII_TXEN: U603.126 (PG11,SPI1_SCK,I2S1_CK,SPDIF_RX0,SDMMC2_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); also elsewhere on the board
/MCU/MCU_DEFAULT: J602.1, R607.2, U603.73 (PB12,TIM1_BKIN,I2C2_SMBA,SPI2_NSS,I2S2_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)
/MCU/MCU_FLASH1_CS: U601.1 (~CS), U603.53 (PF13,I2C4_SMBA,DFSDM1_DATIN6,FMC_A7,EVE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)
/MCU/MCU_FLASH2_CS: U602.1 (~CS), U603.54 (PF14,I2C4_SCL,DFSDM1_CKIN6,FMC_A8,EVENT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)
/MCU/MCU_SPI3_MISO: R601.2, U601.2 (SO), U602.2 (SO), U603.112 (PC11,DFSDM1_DATIN5,SPI3_MISO,USART3_RX,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)
/MCU/MCU_SPI3_MOSI: U601.5 (SI), U602.5 (SI), U603.113 (PC12,TRACED3,SPI3_MOSI,I2S3_SD,USART3_C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)
/MCU/MCU_SPI3_SCLK: U601.6 (SCK), U602.6 (SCK), U603.111 (PC10,DFSDM1_CKIN5,SPI3_SCK,I2S3_CK,USAR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)
/MCU/MCU_TCK_SWCLK: J601.4, U603.109 (PA14,JTCK-SWCLK,EVENTOUT)
/MCU/MCU_TDI: J601.8, U603.110 (PA15,JTDI,TIM2_CH1,TIM2_ETR,HDMI_CEC,SP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)
/MCU/MCU_TDO: J601.6, U603.133 (PB3,JTDO,TRACESWO,TIM2_CH2,SPI1_SCK,I2S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)
/MCU/MCU_TMS_SWDIO: J601.2, U603.105 (PA13,JTMS-SWDIO,EVENTOUT)
/MCU/MCU_VDDA: C621.1, FB601.1, U603.32 (VREF+), U603.33 (VDDA)
/MCU/RELAY1_SCLK: U603.19 (PF7,TIM11_CH1,SPI5_SCK,SAI1_MCLK_B,UART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); also elsewhere on the board
/MCU/RELAY1_SI: U603.21 (PF9,SPI5_MOSI,SAI1_FS_B,UART7_CTS,TIM14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); also elsewhere on the board
/MCU/RELAY1_SO: U603.20 (PF8,SPI5_MISO,SAI1_SCK_B,UART7_RTS,TIM1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); also elsewhere on the board
/MCU/RELAY1_~CS0: U603.59 (PE8,TIM1_CH1N,DFSDM1_CKIN2,UART7_TX,QUA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); also elsewhere on the board
/MCU/RELAY1_~CS1: U603.58 (PE7,TIM1_ETR,DFSDM1_DATIN2,UART7_RX,QUA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); also elsewhere on the board
/MCU/RELAY1_~CS2: U603.57 (PG1,FMC_A11,EVENTOUT); also elsewhere on the board
/MCU/RELAY1_~CS3: U603.56 (PG0,FMC_A10,EVENTOUT); also elsewhere on the board
/MCU/RELAY1_~CS4: U603.55 (PF15,I2C4_SDA,FMC_A9,EVENTOUT); also elsewhere on the board
/MCU/RELAY1_~RST: U603.46 (PB0,TIM1_CH2N,TIM3_CH3,TIM8_CH2N,DFSDM1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); also elsewhere on the board
/MCU/RMII_TX0: U603.128 (PG13,TRACED0,LPTIM1_OUT,SPI6_SCK,USART6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); also elsewhere on the board
/MCU/RMII_TX1: U603.129 (PG14,TRACED1,LPTIM1_ETR,SPI6_MOSI,USART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); also elsewhere on the board
GND: C601.2, C602.2, C603.2, C604.2, C605.2, C606.2, C607.2, C608.2, C609.2, C610.2, C611.2, C612.2, C613.2, C614.2, C615.2, C616.2, C617.2, C618.2, C619.2, C620.2, C621.2, J601.3, J601.5, J602.2, R606.2, U601.4 (GND), U602.4 (GND), U603.16 (VSS), U603.31 (VSSA), U603.38 (VSS), U603.51 (VSS), U603.61 (VSS), U603.83 (VSS), U603.94 (VSS), U603.107 (VSS), U603.120 (VSS), U603.130 (VSS); also elsewhere on the board
unnamed: C601.1, U603.23 (PH0,EVENTOUT,OSC_IN), Y601.1
unnamed: C602.1, U603.24 (PH1,EVENTOUT,OSC_OUT), Y601.2
unnamed: C605.1, U603.71 (VCAP_1)
unnamed: C606.1, U603.106 (VCAP_2)
unnamed: D601.1 (K), R602.1
unnamed: D602.1 (K), R603.1
unnamed: D603.1 (K), R604.1
unnamed: R602.2, U603.80 (PD11,I2C4_SMBA,USART3_CTS,QUADSPI_BK1_I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)
unnamed: R603.2, U603.81 (PD12,TIM4_CH1,LPTIM1_IN1,I2C4_SCL,USART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)
unnamed: R604.2, U603.82 (PD13,TIM4_CH2,LPTIM1_OUT,I2C4_SDA,QUADS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)
unnamed: R606.1, U603.138 (BOOT0)

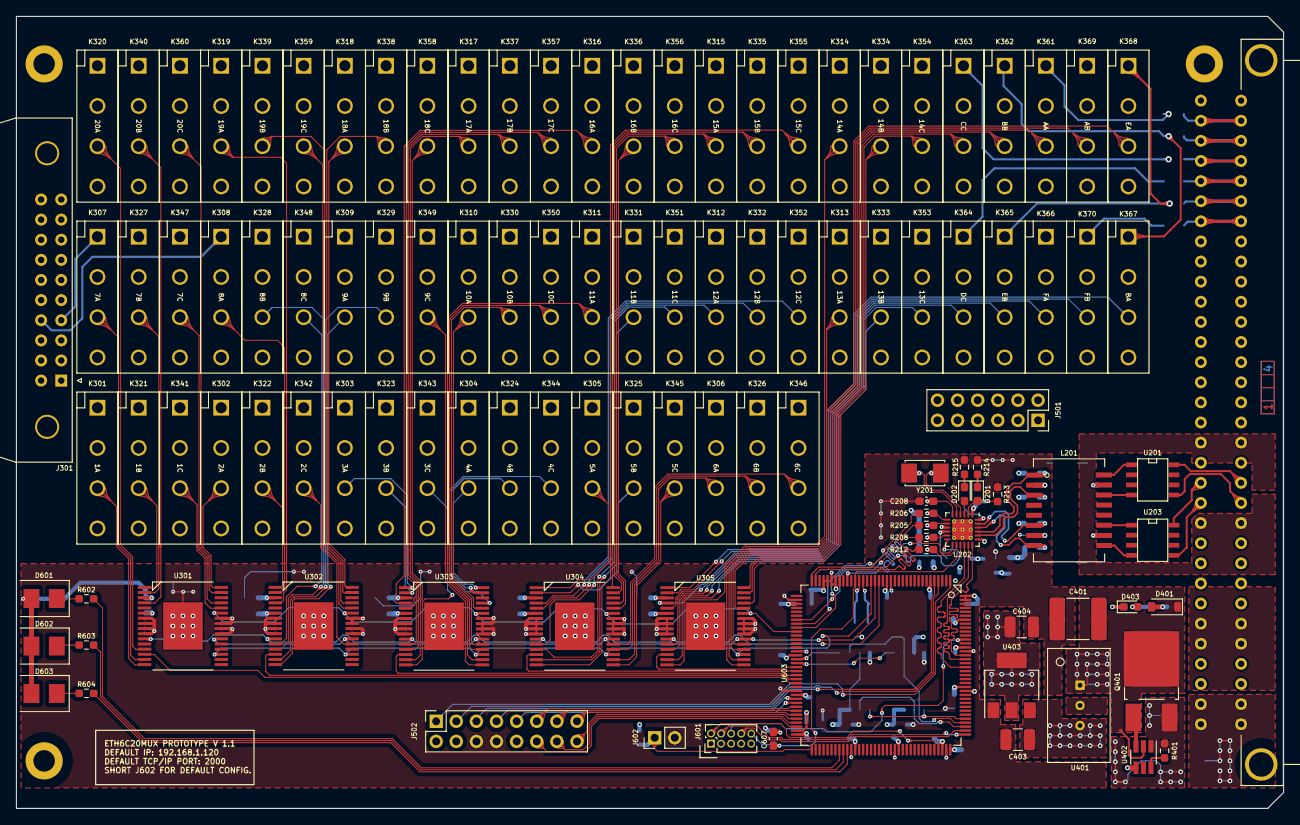
[picture p33: board ETH6C20MUX.kicad_pcb from above]

Board: 4 copper layers, 160.0 x 100.0 mm, 195 parts (0 on the bottom side), 197 nets.
