BehrensG/ETH6C12MUX/software/Core/Inc/defines.h

/*
 * defines.h
 *
 *  Created on: Nov 29, 2019
 *      Author: grzegorz
 */

#ifndef INC_DEFINES_H_
#define INC_DEFINES_H_

#define SCPI_MANUFACTURER_STRING_LENGTH 65
#define SCPI_DEVICE_STRING_LENGTH 11
#define SCPI_SERIALNUMBER_STRING_LENGTH 65
#define SCPI_SOFTWAREVERSION_STRING_LENGTH 65
#define NET_HOSTNAME 255
#define PASSWORD_LENGTH 11
#define PASSWORD "ETH6C20MUX"

#define IP_ADDRESS0 192
#define IP_ADDRESS1 168
#define IP_ADDRESS2 0
#define IP_ADDRESS3 123

#define NETMASK_ADDRESS0 255
#define NETMASK_ADDRESS1 255
#define NETMASK_ADDRESS2 255
#define NETMASK_ADDRESS3 0

#define GATEWAY_ADDRESS0 192
#define GATEWAY_ADDRESS1 168
#define GATEWAY_ADDRESS2 0
#define GATEWAY_ADDRESS3 1

#define TCPIP_PORT 2000

#define MAC0 0x00
#define MAC1 0x80
#define MAC2 0xE1
#define MAC3 0x00
#define MAC4 0x00
#define MAC5 0x00

#define SCPI_INPUT_BUFFER_LENGTH 512
#define SCPI_ERROR_QUEUE_SIZE 24
#define SCPI_IDN1 "GB"
#define SCPI_IDN2 "ETH6C20MUX"
#define SCPI_IDN3 "00000000000000"
#define SCPI_IDN4 "00.00.00.02"

#define DEFAULT_ON 0
#define DEFAULT_OFF 1

#define SECURITY_ON 1
#define SECURITY_OFF 0

#define OFF 0
#define ON 1

#define CURRENT 0
#define STATIC 1

#define ETH_PORT_VAL 65535

#define NET_STR_WRONG_FORMAT 1
#define NET_STR_WRONG_NUMBER 2
#define NET_STR_OK 0

#endif /* INC_DEFINES_H_ */
