BehrensG/ETH6C12MUX/software/Core/Src/main.c

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
/* Includes ------------------------------------------------------------------*/
#include "main.h"
#include "cmsis_os.h"
#include "lwip.h"


SPI_HandleTypeDef hspi3;
SPI_HandleTypeDef hspi4;
SPI_HandleTypeDef hspi5;

/* Definitions for defaultTask */
osThreadId_t defaultTaskHandle;
const osThreadAttr_t defaultTask_attributes = {
  .name = "defaultTask",
  .priority = (osPriority_t) osPriorityNormal,
  .stack_size = 128 * 4
};
void SystemClock_Config(void);
static void MX_GPIO_Init(void);
static void MX_SPI5_Init(void);
static void MX_SPI3_Init(void);
static void MX_SPI4_Init(void);
void StartDefaultTask(void *argument);

/* USER CODE BEGIN 0 */

void BSP_CreateDefaultData()
{
	default_board.scpi_info.manufacturer = (char)malloc(SCPI_MANUFACTURER_STRING_LENGTH*sizeof(char));
	default_board.scpi_info.device = (char)malloc(SCPI_DEVICE_STRING_LENGTH*sizeof(char));
	default_board.scpi_info.serial_number = (char)malloc(SCPI_SERIALNUMBER_STRING_LENGTH*sizeof(char));
	default_board.scpi_info.software_version = (char)malloc(SCPI_SOFTWAREVERSION_STRING_LENGTH*sizeof(char));
	default_board.security.password = (char)malloc(PASSWORD_LENGTH*sizeof(char));
	default_board.ip4_current.hostname = (char)malloc(NET_HOSTNAME*sizeof(char));
	default_board.ip4_static.hostname = (char)malloc(NET_HOSTNAME*sizeof(char));

	default_board.scpi_info.manufacturer = SCPI_IDN1;
	default_board.scpi_info.device = SCPI_IDN2;
	default_board.scpi_info.serial_number = SCPI_IDN3;
	default_board.scpi_info.software_version = SCPI_IDN4;

	default_board.security.on = SECURITY_ON;
	default_board.security.password = PASSWORD;

	default_board.module.detected = FALSE;

	default_board.ip4_static.hostname = default_board.ip4_current.hostname = SCPI_IDN2;
	default_board.ip4_static.ip[0] = default_board.ip4_current.ip[0] = IP_ADDRESS0;
	default_board.ip4_static.ip[1] = default_board.ip4_current.ip[1] = IP_ADDRESS1;
	default_board.ip4_static.ip[2] = default_board.ip4_current.ip[2] = IP_ADDRESS2;
	default_board.ip4_static.ip[3] = default_board.ip4_current.ip[3] = IP_ADDRESS3;

	default_board.ip4_static.netmask[0] = default_board.ip4_current.netmask[0] = NETMASK_ADDRESS0;
	default_board.ip4_static.netmask[1] = default_board.ip4_current.netmask[1] = NETMASK_ADDRESS1;
	default_board.ip4_static.netmask[2] = default_board.ip4_current.netmask[2] = NETMASK_ADDRESS2;
	default_board.ip4_static.netmask[3] = default_board.ip4_current.netmask[3] = NETMASK_ADDRESS3;

	default_board.ip4_static.gateway[0] = default_board.ip4_current.gateway[0] = GATEWAY_ADDRESS0;
	default_board.ip4_static.gateway[1] = default_board.ip4_current.gateway[1] = GATEWAY_ADDRESS1;
	default_board.ip4_static.gateway[2] = default_board.ip4_current.gateway[2] = GATEWAY_ADDRESS2;
	default_board.ip4_static.gateway[3] = default_board.ip4_current.gateway[3] = GATEWAY_ADDRESS3;

	default_board.ip4_static.hw_code = default_board.ip4_current.hw_code = 0;
	default_board.ip4_static.hw_code = default_board.ip4_current.hw_code = 0;


	default_board.ip4_static.MAC[0] = default_board.ip4_current.MAC[0] = MAC0;
	default_board.ip4_static.MAC[1] = default_board.ip4_current.MAC[1] = MAC1;
	default_board.ip4_static.MAC[2] = default_board.ip4_current.MAC[2] = MAC2;
	default_board.ip4_static.MAC[3] = default_board.ip4_current.MAC[3] = MAC3;
	default_board.ip4_static.MAC[4] = default_board.ip4_current.MAC[4] = MAC4;
	default_board.ip4_static.MAC[5] = default_board.ip4_current.MAC[5] = MAC5;

	default_board.default_config = DEFAULT_OFF;

	board = default_board;

}

uint8_t BSP_ReadHWCode()
{
	uint8_t result = 0;

	result = (uint8_t)((HAL_GPIO_ReadPin(ETH_CODE4_GPIO_Port, ETH_CODE4_Pin) << 4) | (HAL_GPIO_ReadPin(ETH_CODE3_GPIO_Port, ETH_CODE3_Pin) << 3) |
			 (HAL_GPIO_ReadPin(ETH_CODE2_GPIO_Port, ETH_CODE2_Pin) << 2) | (HAL_GPIO_ReadPin(ETH_CODE1_GPIO_Port, ETH_CODE1_Pin) << 1) |
			 (HAL_GPIO_ReadPin(ETH_CODE0_GPIO_Port, ETH_CODE0_Pin)));

	return result;
}

void BSP_DetectDefaultConfig()
{
	board.default_config = !HAL_GPIO_ReadPin(MCU_DEFAULT_GPIO_Port, MCU_DEFAULT_Pin);
}


/* USER CODE END 0 */

/**
  * @brief  The application entry point.
  * @retval int
  */
int main(void)
{
  /* MCU Configuration--------------------------------------------------------*/

  /* Reset of all peripherals, Initializes the Flash interface and the Systick. */
  HAL_Init();

  /* Configure the system clock */
  SystemClock_Config();

  /* Initialize all configured peripherals */
  MX_GPIO_Init();
  MX_SPI5_Init();
  MX_SPI3_Init();
  MX_SPI4_Init();
  /* USER CODE BEGIN 2 */

  BSP_CreateDefaultData();
  BSP_DetectDefaultConfig();
  //BSP_PinInit();

  MX_LWIP_Init();

  SPI_FLASH_BoardDefault(FALSE);
  SPI_FLASH_ReadData();

  MATRIX_InitMain();
  MATRIX_ResetSPICommands();

  /* USER CODE END 2 */

  /* Init scheduler */
  osKernelInitialize();

  /* USER CODE BEGIN RTOS_MUTEX */
  /* add mutexes, ... */
  /* USER CODE END RTOS_MUTEX */

  /* USER CODE BEGIN RTOS_SEMAPHORES */
  /* add semaphores, ... */
  /* USER CODE END RTOS_SEMAPHORES */

  /* USER CODE BEGIN RTOS_TIMERS */
  /* start timers, add new ones, ... */
  /* USER CODE END RTOS_TIMERS */

  /* USER CODE BEGIN RTOS_QUEUES */
  /* add queues, ... */
  /* USER CODE END RTOS_QUEUES */

  /* Create the thread(s) */
  /* creation of defaultTask */
  //defaultTaskHandle = osThreadNew(StartDefaultTask, NULL, &defaultTask_attributes);

  /* USER CODE BEGIN RTOS_THREADS */
  /* add threads, ... */
  scpi_server_init();
  /* USER CODE END RTOS_THREADS */

  /* USER CODE BEGIN RTOS_EVENTS */
  /* add events, ... */
  /* USER CODE END RTOS_EVENTS */

  /* Start scheduler */
  osKernelStart();

  /* We should never get here as control is now taken by the scheduler */
  /* Infinite loop */
  /* USER CODE BEGIN WHILE */
  while(1)
  {

  }

    /* USER CODE END WHILE */

}

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
/* USER CODE BEGIN Header_StartDefaultTask */
/**
  * @brief  Function implementing the defaultTask thread.
  * @param  argument: Not used
  * @retval None
  */
/* USER CODE END Header_StartDefaultTask */
void StartDefaultTask(void *argument)
{
  /* init code for LWIP */
  MX_LWIP_Init();
  /* USER CODE BEGIN 5 */
  /* Infinite loop */
  for(;;)
  {
    osDelay(1);
  }
  /* USER CODE END 5 */
}

 /**
  * @brief  Period elapsed callback in non blocking mode
  * @note   This function is called  when TIM1 interrupt took place, inside
  * HAL_TIM_IRQHandler(). It makes a direct call to HAL_IncTick() to increment
  * a global variable "uwTick" used as application time base.
  * @param  htim : TIM handle
  * @retval None
  */
void HAL_TIM_PeriodElapsedCallback(TIM_HandleTypeDef *htim)
{
  if (htim->Instance == TIM1) {
    HAL_IncTick();
  }
}

/**
  * @brief  This function is executed in case of error occurrence.
  * @retval None
  */
void Error_Handler(void)
{
  /* USER CODE BEGIN Error_Handler_Debug */
  /* User can add his own implementation to report the HAL error return state */

  /* USER CODE END Error_Handler_Debug */
}

#ifdef  USE_FULL_ASSERT
/**
  * @brief  Reports the name of the source file and the source line number
  *         where the assert_param error has occurred.
  * @param  file: pointer to the source file name
  * @param  line: assert_param error line source number
  * @retval None
  */
void assert_failed(uint8_t *file, uint32_t line)
{
  /* USER CODE BEGIN 6 */
  /* User can add his own implementation to report the file name and line number,
     tex: printf("Wrong parameters value: file %s on line %d\r\n", file, line) */
  /* USER CODE END 6 */
}
#endif /* USE_FULL_ASSERT */

/************************ (C) COPYRIGHT STMicroelectronics *****END OF FILE****/
