BehrensG/ETH6C12MUX/software/Core/Inc/main.h

#define RELAY1_nRST_Pin GPIO_PIN_0
#define RELAY1_nRST_GPIO_Port GPIOB
#define MCU_FLASH1_CS_Pin GPIO_PIN_13
#define MCU_FLASH1_CS_GPIO_Port GPIOF
#define MCU_FLASH2_CS_Pin GPIO_PIN_14
#define MCU_FLASH2_CS_GPIO_Port GPIOF
#define RELAY1_nCS4_Pin GPIO_PIN_15
#define RELAY1_nCS4_GPIO_Port GPIOF
#define RELAY1_nCS3_Pin GPIO_PIN_0
#define RELAY1_nCS3_GPIO_Port GPIOG
#define RELAY1_nCS2_Pin GPIO_PIN_1
#define RELAY1_nCS2_GPIO_Port GPIOG
#define RELAY1_nCS1_Pin GPIO_PIN_7
#define RELAY1_nCS1_GPIO_Port GPIOE
#define RELAY1_nCS0_Pin GPIO_PIN_8
#define RELAY1_nCS0_GPIO_Port GPIOE
#define RELAY2_nRST_Pin GPIO_PIN_10
#define RELAY2_nRST_GPIO_Port GPIOE
#define RELAY2_nCS0_Pin GPIO_PIN_11
#define RELAY2_nCS0_GPIO_Port GPIOE
#define RELAY2_nCS1_Pin GPIO_PIN_12
#define RELAY2_nCS1_GPIO_Port GPIOE
#define RELAY2_nCS2_Pin GPIO_PIN_13
#define RELAY2_nCS2_GPIO_Port GPIOE
#define RELAY2_nCS3_Pin GPIO_PIN_14
#define RELAY2_nCS3_GPIO_Port GPIOE
#define RELAY2_nCS4_Pin GPIO_PIN_15
#define RELAY2_nCS4_GPIO_Port GPIOE
#define MODULE_DETECT1_Pin GPIO_PIN_10
#define MODULE_DETECT1_GPIO_Port GPIOB
#define MODULE_DETECT0_Pin GPIO_PIN_11
#define MODULE_DETECT0_GPIO_Port GPIOB
#define MCU_DEFAULT_Pin GPIO_PIN_12
#define MCU_DEFAULT_GPIO_Port GPIOB
#define ETH_CODE4_Pin GPIO_PIN_13
#define ETH_CODE4_GPIO_Port GPIOB
#define ETH_CODE3_Pin GPIO_PIN_14
#define ETH_CODE3_GPIO_Port GPIOB
#define ETH_CODE2_Pin GPIO_PIN_15
#define ETH_CODE2_GPIO_Port GPIOB
#define ETH_CODE1_Pin GPIO_PIN_8
#define ETH_CODE1_GPIO_Port GPIOD
#define ETH_CODE0_Pin GPIO_PIN_9
#define ETH_CODE0_GPIO_Port GPIOD
#define LED_RED_Pin GPIO_PIN_11
#define LED_RED_GPIO_Port GPIOD
#define LED_GREEN_Pin GPIO_PIN_12
#define LED_GREEN_GPIO_Port GPIOD
#define LED_BLUE_Pin GPIO_PIN_13
#define LED_BLUE_GPIO_Port GPIOD
