BehrensG/ETH6C12MUX/software/Core/Src/matrix.c

/*
 * relays.c
 *
 *  Created on: Dec 17, 2019
 *      Author: grzegorz
 */

#include "matrix.h"
#include "main.h"


void MATRIX_DetectModule()
{
	board.module.detected = HAL_GPIO_ReadPin(MODULE_DETECT0_GPIO_Port, MODULE_DETECT0_Pin) && HAL_GPIO_ReadPin(MODULE_DETECT1_GPIO_Port, MODULE_DETECT1_Pin);
}

void MATRIX_InitMain()
{
	matrix.relays[0].id = "01A";
	matrix.relays[0].state = OPEN;
	matrix.relays[0].type = MAIN;
	matrix.relays[0].MCZ33996.cs = 0;
	matrix.relays[0].MCZ33996.spi = 5;
	matrix.relays[0].MCZ33996.out = 0;
    matrix.relays[0].index = 0;

	matrix.relays[1].id = "01B";
	matrix.relays[1].state = OPEN;
	matrix.relays[1].type = MAIN;
	matrix.relays[1].MCZ33996.cs = 0;
	matrix.relays[1].MCZ33996.spi = 5;
	matrix.relays[1].MCZ33996.out = 7;
    matrix.relays[1].index = 0;

	matrix.relays[2].id = "01C";
	matrix.relays[2].state = OPEN;
	matrix.relays[2].type = MAIN;
	matrix.relays[2].MCZ33996.cs = 0;
	matrix.relays[2].MCZ33996.spi = 5;
	matrix.relays[2].MCZ33996.out = 8;
    matrix.relays[2].index = 0;

	matrix.relays[3].id = "02A";
	matrix.relays[3].state = OPEN;
	matrix.relays[3].type = MAIN;
	matrix.relays[3].MCZ33996.cs = 1;
	matrix.relays[3].MCZ33996.spi = 5;
	matrix.relays[3].MCZ33996.out = 7;
    matrix.relays[3].index = 1;

	matrix.relays[4].id = "02B";
	matrix.relays[4].state = OPEN;
	matrix.relays[4].type = MAIN;
	matrix.relays[4].MCZ33996.cs = 1;
	matrix.relays[4].MCZ33996.spi = 5;
	matrix.relays[4].MCZ33996.out = 6;
    matrix.relays[4].index = 1;

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
    matrix.relays[129].index = 9;

	matrix.relays[130].id = "BE";
	matrix.relays[130].state = OPEN;
	matrix.relays[130].type = MODULE;
	matrix.relays[130].MCZ33996.cs = 4;
	matrix.relays[130].MCZ33996.spi = 4;
	matrix.relays[130].MCZ33996.out = 10;
    matrix.relays[130].index = 9;

	matrix.relays[131].id = "AF";
	matrix.relays[131].state = OPEN;
	matrix.relays[131].type = MODULE;
	matrix.relays[131].MCZ33996.cs = 4;
	matrix.relays[131].MCZ33996.spi = 4;
	matrix.relays[131].MCZ33996.out = 9;
    matrix.relays[131].index = 9;

    matrix.spi_commands[0].cs = 0;
    matrix.spi_commands[0].enabled = FALSE;
    matrix.spi_commands[0].spi = 5;
    matrix.spi_commands[0].tx_tmp = 0;

    matrix.spi_commands[1].cs = 1;
    matrix.spi_commands[1].enabled = FALSE;
    matrix.spi_commands[1].spi = 5;
    matrix.spi_commands[1].tx_tmp = 0;

    matrix.spi_commands[2].cs = 2;
    matrix.spi_commands[2].enabled = FALSE;
    matrix.spi_commands[2].spi = 5;
    matrix.spi_commands[2].tx_tmp = 0;

    matrix.spi_commands[3].cs = 3;
    matrix.spi_commands[3].enabled = FALSE;
    matrix.spi_commands[3].spi = 5;
    matrix.spi_commands[3].tx_tmp = 0;

    matrix.spi_commands[4].cs = 4;
    matrix.spi_commands[4].enabled = FALSE;
    matrix.spi_commands[4].spi = 5;
    matrix.spi_commands[4].tx_tmp = 0;

    matrix.spi_commands[5].cs = 5;
    matrix.spi_commands[5].enabled = FALSE;
    matrix.spi_commands[5].spi = 4;
    matrix.spi_commands[5].tx_tmp = 0;

    matrix.spi_commands[6].cs = 6;
    matrix.spi_commands[6].enabled = FALSE;
    matrix.spi_commands[6].spi = 4;
    matrix.spi_commands[6].tx_tmp = 0;

    matrix.spi_commands[7].cs = 7;
    matrix.spi_commands[7].enabled = FALSE;
    matrix.spi_commands[7].spi = 4;
    matrix.spi_commands[7].tx_tmp = 0;

    matrix.spi_commands[8].cs = 8;
    matrix.spi_commands[8].enabled = FALSE;
    matrix.spi_commands[8].spi = 4;
    matrix.spi_commands[8].tx_tmp = 0;

    matrix.spi_commands[9].cs = 9;
    matrix.spi_commands[9].enabled = FALSE;
    matrix.spi_commands[9].spi = 4;
    matrix.spi_commands[9].tx_tmp = 0;
}

void MATRIX_ResetSPICommands()
{
	for(uint8_t i = 0; i < SPI_CMD_SIZE; i++)
	{
		matrix.spi_commands[i].enabled = TRUE;
		matrix.spi_commands[i].tx_tmp = 0;
		matrix.spi_commands[i].tx_data[0] = 0x00;
		matrix.spi_commands[i].tx_data[1] = 0x00;
		matrix.spi_commands[i].tx_data[2] = 0x00;
	}
}
