BehrensG/ETH6C12MUX/software/Core/Src/spi_flash.c

/*
 * spi_flash.c
 *
 *  Created on: Nov 29, 2019
 *      Author: grzegorz
 */

#include <types.h>

#include "main.h"
#include "spi_flash.h"
#include "defines.h"


volatile int flash0_busy_flg;
volatile int flash1_busy_flg;


extern SPI_HandleTypeDef hspi3;

extern struct _board board;
extern struct _board default_board;

static void SPI_FLASH_Select(uint8_t id)
{

  if(id==0) HAL_GPIO_WritePin(MCU_FLASH1_CS_GPIO_Port, MCU_FLASH1_CS_Pin, GPIO_PIN_RESET);
  if(id==1) HAL_GPIO_WritePin(MCU_FLASH2_CS_GPIO_Port, MCU_FLASH2_CS_Pin, GPIO_PIN_RESET);

  if(id==0) flash0_busy_flg=1;
  if(id==1) flash1_busy_flg=1;

}

static void SPI_FLASH_Deselect(uint8_t id)
{

  if(id==0) HAL_GPIO_WritePin(MCU_FLASH1_CS_GPIO_Port, MCU_FLASH1_CS_Pin, GPIO_PIN_SET);
  if(id==1) HAL_GPIO_WritePin(MCU_FLASH2_CS_GPIO_Port, MCU_FLASH2_CS_Pin, GPIO_PIN_SET);

  if(id==0) flash0_busy_flg=1;
  if(id==1) flash1_busy_flg=1;

}


uint8_t * SPI_FLASH_GetManufacturerID(uint8_t id)
{
	static uint8_t manf_id[3];
	uint32_t timeout = 1000;
	uint8_t tx_data = 0xFF;

  //select flash
  SPI_FLASH_Select(id);

  tx_data = FLASH_RDID;
  HAL_SPI_Transmit(&hspi3, &tx_data, 1, timeout);
  HAL_SPI_Receive(&hspi3, manf_id, 3, timeout);
  //deselect flash
  SPI_FLASH_Deselect(id);


  return manf_id;
}

static uint8_t SPI_FLASH_IsBusy(uint8_t id)
{
	uint32_t timeout = 1000;
	uint8_t instruction = FLASH_RDSR;
	uint8_t busy;

	SPI_FLASH_Select(id);
	HAL_SPI_Transmit(&hspi3, &instruction, 1, timeout);
	HAL_SPI_Receive(&hspi3, &busy, 1, timeout);
	SPI_FLASH_Deselect(id);

	if(busy & FLASH_BUSY)
	{
		return 1;
	}else
	{
		return 0;
	}
}

static void SPI_FLASH_Wait(uint8_t id)
{
	while(SPI_FLASH_IsBusy(id))
	{}
}

void SPI_FLASH_Read(uint32_t address, uint8_t* buffer, uint16_t len, uint8_t id)
{
	uint32_t timeout = 1000;
	uint8_t instruction = FLASH_READ;
	uint8_t tx_data = 0x00;

	SPI_FLASH_Wait(id);

	SPI_FLASH_Select(id);

	HAL_SPI_Transmit(&hspi3, &instruction, 1, timeout);
	tx_data = address >> 16;
	HAL_SPI_Transmit(&hspi3, &tx_data, 1, timeout);
	tx_data = address >> 8;
	HAL_SPI_Transmit(&hspi3, &tx_data, 1, timeout);
	tx_data = address & 0xFF;
	HAL_SPI_Transmit(&hspi3, &tx_data, 1, timeout);

	HAL_SPI_Receive(&hspi3, buffer, len, timeout);

	SPI_FLASH_Deselect(id);

}

void SPI_FLASH_WriteByte(uint32_t address, uint8_t val, uint8_t id)
{
	uint32_t timeout = 1000;
	uint8_t instruction = FLASH_WREN;
	uint8_t tx_data = 0xFF;
	//uint8_t rx_data = val;

	SPI_FLASH_Wait(id);

	SPI_FLASH_Select(id);
	HAL_SPI_Transmit(&hspi3, &instruction, 1, timeout);
	SPI_FLASH_Deselect(id);

	SPI_FLASH_Select(id);
	instruction = FLASH_BYTE_PGM;
	HAL_SPI_Transmit(&hspi3, &instruction, 1, timeout);
	tx_data  = (address >> 16) & 0xFF;
	HAL_SPI_Transmit(&hspi3, &tx_data, 1, timeout);
	tx_data = (address >> 8) & 0xFF;
	HAL_SPI_Transmit(&hspi3, &tx_data, 1, timeout);
	tx_data = address & 0xFF;
	HAL_SPI_Transmit(&hspi3, &tx_data, 1, timeout);
	tx_data = val;
	HAL_SPI_Transmit(&hspi3, &tx_data, 1, timeout);

	SPI_FLASH_Deselect(id);
}

void SPI_FLASH_EraseAll(uint8_t id)
{
	uint32_t timeout = 1000;
	uint8_t instruction = FLASH_WREN;

	SPI_FLASH_Select(id);
	HAL_SPI_Transmit(&hspi3, &instruction, 1, timeout);
	SPI_FLASH_Deselect(id);

	SPI_FLASH_Select(id);
	instruction = FLASH_CHIP_ERASE;
	HAL_SPI_Transmit(&hspi3, &instruction, 1, timeout);
	SPI_FLASH_Deselect(id);
}

uint8_t SPI_FLASH_IsProtected(uint8_t id)
{
	uint32_t timeout = 1000;
	uint8_t instruction = FLASH_RDSR;
	uint8_t flash_status = 0x00;

	SPI_FLASH_Select(id);
	HAL_SPI_Transmit(&hspi3, &instruction, 1, timeout);
	HAL_SPI_Receive(&hspi3, &flash_status, 1, timeout);
	SPI_FLASH_Deselect(id);

	if (flash_status & (FLASH_BP0 | FLASH_BP1 | FLASH_BP2 | FLASH_BP3))
	{
		return 1;
	}
	else
	{
		return 0;
	}
}

uint8_t SPI_FLASH_DefaultStatus(uint8_t id)
{
	uint32_t timeout = 1000;
	uint8_t instruction = FLASH_READ;
	uint8_t tx_data = 0x00;
	uint8_t rx_data = 0xFF;
	uint32_t address = 0x00000000;

	SPI_FLASH_Wait(id);

	SPI_FLASH_Select(id);

	HAL_SPI_Transmit(&hspi3, &instruction, 1, timeout);
	tx_data = address >> 16;
	HAL_SPI_Transmit(&hspi3, &tx_data, 1, timeout);
	tx_data = address >> 8;
	HAL_SPI_Transmit(&hspi3, &tx_data, 1, timeout);
	tx_data = address & 0xFF;
	HAL_SPI_Transmit(&hspi3, &tx_data, 1, timeout);

	HAL_SPI_Receive(&hspi3, &rx_data, 1, timeout);

	SPI_FLASH_Deselect(id);

	return rx_data;

}

static void SPI_FLASH_Erase4k(uint32_t address, uint8_t id)
{
	uint8_t instruction = FLASH_WREN;
	uint8_t tx_data = 0xFF;
	uint32_t timeout = 1000;

	SPI_FLASH_Wait(id);

	SPI_FLASH_Select(id);
	HAL_SPI_Transmit(&hspi3, &instruction, 1, timeout);
	tx_data = (address >> 16) & 0xFF;
	HAL_SPI_Transmit(&hspi3, &tx_data, 1, timeout);
	tx_data = (address >> 8) & 0xFF;
	HAL_SPI_Transmit(&hspi3, &tx_data, 1, timeout);
	tx_data = address & 0xFF;
	HAL_SPI_Transmit(&hspi3, &tx_data, 1, timeout);
	SPI_FLASH_Deselect(id);
}

void SPI_FLASH_BoardDefault(uint8_t force)
{
	uint32_t index = 0x00000000;
	uint8_t tx_data = 0xFF;
	uint8_t id = 0;

	if(FALSE == force)
	{

		if (SPI_FLASH_DEFAULT_STATUS == SPI_FLASH_DefaultStatus(id))
		{
			return;
		}
		SPI_FLASH_Erase4k(index, 0);

		SPI_FLASH_WriteByte(index, SPI_FLASH_DEFAULT_STATUS, 0);
		index++;

		for(uint16_t i = 0; i < SCPI_MANUFACTURER_STRING_LENGTH; i++)
		{
			SPI_FLASH_WriteByte(index, default_board.scpi_info.manufacturer[i], 0);
			index++;
		}

		for(uint16_t i = 0; i < SCPI_DEVICE_STRING_LENGTH; i++)
		{
			SPI_FLASH_WriteByte(index, default_board.scpi_info.device[i], 0);
			index++;
		}

		for(uint16_t i = 0; i < SCPI_SOFTWAREVERSION_STRING_LENGTH; i++)
		{
			SPI_FLASH_WriteByte(index, default_board.scpi_info.software_version[i], 0);
			index++;
		}

		for(uint16_t i = 0; i < 4; i++)
		{
			SPI_FLASH_WriteByte(index, default_board.ip4_static.ip[i], 0);
			index++;
		}

		for(uint16_t i = 0; i < 4; i++)
		{
			SPI_FLASH_WriteByte(index, default_board.ip4_static.netmask[i], 0);
			index++;
		}

		for(uint16_t i = 0; i < 4; i++)
		{
			SPI_FLASH_WriteByte(index, default_board.ip4_static.gateway[i], 0);
			index++;
		}


		tx_data = board.ip4_static.port >> 8;
		SPI_FLASH_WriteByte(index, tx_data, 0);
		index++;

		tx_data = board.ip4_static.port;
		SPI_FLASH_WriteByte(index, tx_data, 0);
		index++;

		SPI_FLASH_WriteByte(index, board.ip4_static.hw_code, 0);
		index++;

		for(uint16_t i = 0; i < NET_HOSTNAME; i++)
		{
			SPI_FLASH_WriteByte(index, default_board.ip4_static.hostname[i], 0);
			index++;
		}

		for(uint16_t i = 0; i < SCPI_SERIALNUMBER_STRING_LENGTH; i++)
		{
			SPI_FLASH_WriteByte(index, default_board.scpi_info.serial_number[i], 0);
			index++;
		}

		for(uint16_t i = 0; i < 6; i++)
		{
			SPI_FLASH_WriteByte(index, default_board.ip4_static.MAC[i], 0);
			index++;
		}

		for(uint16_t i = 0; i < PASSWORD_LENGTH; i++)
		{
			SPI_FLASH_WriteByte(index, default_board.security.password[i], 0);
			index++;
		}

	}
	else if (TRUE == force)
	{
		SPI_FLASH_Erase4k(index, 0);

		for(uint16_t i = 0; i < SCPI_MANUFACTURER_STRING_LENGTH; i++)
		{
			SPI_FLASH_WriteByte(index, default_board.scpi_info.manufacturer[i], 0);
			index++;
		}

		for(uint16_t i = 0; i < SCPI_DEVICE_STRING_LENGTH; i++)
		{
			SPI_FLASH_WriteByte(index, default_board.scpi_info.device[i], 0);
			index++;
		}

		for(uint16_t i = 0; i < SCPI_SOFTWAREVERSION_STRING_LENGTH; i++)
		{
			SPI_FLASH_WriteByte(index, default_board.scpi_info.software_version[i], 0);
			index++;
		}

		for(uint16_t i = 0; i < 4; i++)
		{
			SPI_FLASH_WriteByte(index, default_board.ip4_static.ip[i], 0);
			index++;
		}

		for(uint16_t i = 0; i < 4; i++)
		{
			SPI_FLASH_WriteByte(index, default_board.ip4_static.netmask[i], 0);
			index++;
		}

		for(uint16_t i = 0; i < 4; i++)
		{
			SPI_FLASH_WriteByte(index, default_board.ip4_static.gateway[i], 0);
			index++;
		}


		tx_data = board.ip4_static.port >> 8;
		SPI_FLASH_WriteByte(index, tx_data, 0);
		index++;

		tx_data = board.ip4_static.port;
		SPI_FLASH_WriteByte(index, tx_data, 0);
		index++;

		SPI_FLASH_WriteByte(index, board.ip4_static.hw_code, 0);
		index++;

		for(uint16_t i = 0; i < NET_HOSTNAME; i++)
		{
			SPI_FLASH_WriteByte(index, default_board.ip4_static.hostname[i], 0);
			index++;
		}

		for(uint16_t i = 0; i < SCPI_SERIALNUMBER_STRING_LENGTH; i++)
		{
			SPI_FLASH_WriteByte(index, default_board.scpi_info.serial_number[i], 0);
			index++;
		}

		for(uint16_t i = 0; i < 6; i++)
		{
			SPI_FLASH_WriteByte(index, default_board.ip4_static.MAC[i], 0);
			index++;
		}

		for(uint16_t i = 0; i < PASSWORD_LENGTH; i++)
		{
			SPI_FLASH_WriteByte(index, default_board.security.password[i], 0);
			index++;
		}
	}
}

void SPI_FLASH_BoardUpdate()
{
	uint32_t index = 0x00000000;
	uint8_t tx_data = 0xFF;

	SPI_FLASH_Erase4k(index, 0);

	SPI_FLASH_WriteByte(index, SPI_FLASH_DEFAULT_STATUS, 0);
	index++;

	for(uint16_t i = 0; i < SCPI_MANUFACTURER_STRING_LENGTH; i++)
	{
		SPI_FLASH_WriteByte(index, board.scpi_info.manufacturer[i], 0);
		index++;
	}

	for(uint16_t i = 0; i < SCPI_DEVICE_STRING_LENGTH; i++)
	{
		SPI_FLASH_WriteByte(index, board.scpi_info.device[i], 0);
		index++;
	}

	for(uint16_t i = 0; i < SCPI_SOFTWAREVERSION_STRING_LENGTH; i++)
	{
		SPI_FLASH_WriteByte(index, board.scpi_info.software_version[i], 0);
		index++;
	}

	for(uint16_t i = 0; i < 4; i++)
	{
		SPI_FLASH_WriteByte(index, board.ip4_current.ip[i], 0);
		index++;
	}

	for(uint16_t i = 0; i < 4; i++)
	{
		SPI_FLASH_WriteByte(index, board.ip4_current.netmask[i], 0);
		index++;
	}

	for(uint16_t i = 0; i < 4; i++)
	{
		SPI_FLASH_WriteByte(index, board.ip4_current.gateway[i], 0);
		index++;
	}

	tx_data = (uint8_t)(board.ip4_current.port >> 8);
	SPI_FLASH_WriteByte(index, tx_data, 0);
	index++;

	tx_data = (uint8_t)(board.ip4_current.port);
	SPI_FLASH_WriteByte(index, tx_data, 0);
	index++;

	for(uint16_t i = 0; i < NET_HOSTNAME; i++)
	{
		SPI_FLASH_WriteByte(index, default_board.ip4_current.hostname[i], 0);
		index++;
	}

	if(SECURITY_OFF == board.security.on)
	{

		for(uint16_t i = 0; i < SCPI_SERIALNUMBER_STRING_LENGTH; i++)
		{
			SPI_FLASH_WriteByte(index, board.scpi_info.serial_number[i], 0);
			index++;
		}

		for(uint16_t i = 0; i < 6; i++)
		{
			SPI_FLASH_WriteByte(index, board.ip4_current.MAC[i], 0);
			index++;
		}

		for(uint16_t i = 0; i < PASSWORD_LENGTH; i++)
		{
			SPI_FLASH_WriteByte(index, board.security.password[i], 0);
			index++;
		}

	}
	else if(SECURITY_ON == board.security.on)
	{

		for(uint16_t i = 0; i < SCPI_SERIALNUMBER_STRING_LENGTH; i++)
		{
			SPI_FLASH_WriteByte(index, default_board.scpi_info.serial_number[i], 0);
			index++;
		}

		for(uint16_t i = 0; i < 6; i++)
		{
			SPI_FLASH_WriteByte(index, default_board.ip4_current.MAC[i], 0);
			index++;
		}

		for(uint16_t i = 0; i < PASSWORD_LENGTH; i++)
		{
			SPI_FLASH_WriteByte(index, default_board.security.password[i], 0);
			index++;
		}

	}

}

void SPI_FLASH_ReadData()
{
	uint32_t index = 0x00000001;
	uint8_t rx_data[2] = {0xFF, 0xFF};

	for(uint16_t i = 0; i < SCPI_MANUFACTURER_STRING_LENGTH; i++)
	{
		SPI_FLASH_Read(index, board.scpi_info.manufacturer[i], 1, 0);
		index++;
	}

	for(uint16_t i = 0; i < SCPI_DEVICE_STRING_LENGTH; i++)
	{
		SPI_FLASH_Read(index, board.scpi_info.device[i], 1, 0);
		index++;
	}

	for(uint16_t i = 0; i < SCPI_SOFTWAREVERSION_STRING_LENGTH; i++)
	{
		SPI_FLASH_Read(index, board.scpi_info.software_version[i], 1, 0);
		index++;
	}

	if(board.default_config)
	{
		for(uint16_t i = 0; i < 4; i++)
		{
			SPI_FLASH_Read(index, board.ip4_static.ip[i], 1, 0);
			index++;
		}

		for(uint16_t i = 0; i < 4; i++)
		{
			SPI_FLASH_Read(index, board.ip4_static.netmask[i], 1, 0);
			index++;
		}

		for(uint16_t i = 0; i < 4; i++)
		{
			SPI_FLASH_Read(index, board.ip4_static.gateway[i], 1, 0);
			index++;
		}

		SPI_FLASH_Read(index, rx_data[0], 1, 0);
		board.ip4_static.port = (uint16_t)(rx_data[0] << 8);
		index++;

		SPI_FLASH_Read(index, rx_data[1], 1,  0);
		board.ip4_static.port += (uint16_t)(rx_data[1]);
		index++;

		for(uint16_t i = 0; i < NET_HOSTNAME; i++)
		{
			SPI_FLASH_Read(index, board.ip4_static.hostname[i], 1, 0);
			index++;
		}
	}
	else
	{
		for(uint16_t i = 0; i < 4; i++)
		{
			SPI_FLASH_WriteByte(index, board.ip4_static.ip[i], 0);
			board.ip4_current.ip[i] = board.ip4_static.ip[i];
			index++;
		}

		for(uint16_t i = 0; i < 4; i++)
		{
			SPI_FLASH_WriteByte(index, board.ip4_static.netmask[i], 0);
			board.ip4_current.netmask[i] = board.ip4_static.netmask[i];
			index++;
		}

		for(uint16_t i = 0; i < 4; i++)
		{
			SPI_FLASH_WriteByte(index, board.ip4_static.gateway[i], 0);
			board.ip4_current.gateway[i] = board.ip4_static.gateway[i];
			index++;
		}

		SPI_FLASH_Read(index, rx_data[0], 1, 0);
		board.ip4_static.port = (uint16_t)(rx_data[0] << 8);
		index++;

		SPI_FLASH_Read(index, rx_data[1], 1,  0);
		board.ip4_static.port += (uint16_t)(rx_data[1]);
		index++;

		board.ip4_current.port = board.ip4_static.port;

		for(uint16_t i = 0; i < NET_HOSTNAME; i++)
		{
			SPI_FLASH_Read(index, board.ip4_static.hostname[i], 1, 0);
			board.ip4_current.hostname[i] = board.ip4_static.hostname[i];
			index++;
		}
	}

	for(uint16_t i = 0; i < SCPI_SERIALNUMBER_STRING_LENGTH; i++)
	{
		SPI_FLASH_Read(index, board.scpi_info.serial_number[i], 1, 0);
		index++;
	}

	for(uint16_t i = 0; i < 6; i++)
	{
		SPI_FLASH_Read(index, board.ip4_current.MAC[i], 1, 0);
		index++;
	}

	for(uint16_t i = 0; i < PASSWORD_LENGTH; i++)
	{
		SPI_FLASH_Read(index, board.security.password[i], 1, 0);
		index++;
	}

}
