BehrensG/ETH6C12MUX/software/Core/Inc/scpi_def.h

/*
 * spi-def.h
 *
 *  Created on: Nov 29, 2019
 *      Author: grzegorz
 */

#ifndef INC_SCPI_DEF_H_
#define INC_SCPI_DEF_H_

#include "scpi/scpi.h"
#include "defines.h"

extern const scpi_command_t scpi_commands[];
extern scpi_interface_t scpi_interface;
extern char scpi_input_buffer[];
extern scpi_error_t scpi_error_queue_data[];
extern scpi_t scpi_context;

size_t SCPI_Write(scpi_t * context, const char * data, size_t len);
int SCPI_Error(scpi_t * context, int_fast16_t err);
scpi_result_t SCPI_Control(scpi_t * context, scpi_ctrl_name_t ctrl, scpi_reg_val_t val);
scpi_result_t SCPI_Reset(scpi_t * context);
scpi_result_t SCPI_Flush(scpi_t * context);

void scpi_server_init(void);
scpi_result_t SCPI_SystemCommTcpipControlQ(scpi_t * context);

#endif /* INC_SCPI_DEF_H_ */
