BehrensG/ETH6C12MUX/(commit log)

2019-09-01 Added Power, MCU, FPGA, Relays, Ethernet, USB and Connector schematics. Created schematic library.
    [Connector.sch, ETH6C12MUX.kicad_pcb, ETH6C12MUX.sch, Ethernet.sch, FPGA.sch, MCU.sch, Power.sch, Relays.sch]
2019-09-02 Schematic design
    [Connector.sch, ETH6C16MUX.kicad_pcb, ETH6C16MUX.sch, Ethernet.sch, FPGA.sch, MCU.sch, Power.sch, Relays.sch]
2019-09-03 USB update
    [ETH6C16MUX.sch, Ethernet.sch, MCU.sch, Power.sch, Relays.sch, USB.sch]
2019-09-05 FPGA schematic
    [ETH6C16MUX.sch, Ethernet.sch, FPGA.sch, MCU.sch, Power.sch]
2019-09-08 PCB design, need to redesign of the board to board connectors.
    [Connector.sch, ETH6C16MUX.sch, Ethernet.sch, FPGA.sch, MCU.sch, Module_connector.sch, Power.sch, Relays.sch]
2019-09-08 PCB layout, board to board connector changed.
    [Connector.sch, ETH6C16MUX.kicad_pcb, ETH6C16MUX.sch, Ethernet.sch, FPGA.sch, MCU.sch, Module_connector.sch, Power.sch]
2019-09-08 PCB layout, deleted USB.
    [Connector.sch, ETH6C16MUX.kicad_pcb, ETH6C16MUX.sch, Ethernet.sch, FPGA.sch, MCU.sch, Power.sch, Relays.sch]
2019-09-12 Deleted FPGA part and change it for SPI IO chips. Change power supply circuit.
    [Connector.sch, ETH6C16MUX.kicad_pcb, ETH6C16MUX.sch, Ethernet.sch, FPGA.sch, MCU.sch, Power.sch, Relays.sch]
2019-09-22 Ranamed project to ETH6C20MUX. Added 4 channels. Schematic redesign and PCB layout.
    [Connector.sch, ETH6C16MUX.kicad_pcb, ETH6C20MUX.kicad_pcb, ETH6C20MUX.sch, Ethernet.sch, FPGA.sch, MCU.sch, Power.sch]
2019-09-22 PCB done.
    [Connector.sch, ETH6C20MUX.sch, MCU.sch, Relays.sch]
2019-09-23 Updated PCB. Added 3D components. Started BOM list.
    [Connector.sch, ETH6C20MUX.csv, ETH6C20MUX.kicad_pcb, ETH6C20MUX.ods, Ethernet.sch, FPGA.sch, MCU.sch, Power.sch]
2019-09-25 Gerber generated.
    [ETH6C20MUX-B_Mask.gbr, ETH6C20MUX-B_Paste.gbr, ETH6C20MUX-B_SilkS.gbr, ETH6C20MUX-Bottom.gbr, ETH6C20MUX-Edge_Cuts.gbr, ETH6C20MUX-F_Mask.gbr, ETH6C20MUX-F_Paste.gbr, ETH6C20MUX-F_SilkS.gbr]
2019-09-25 All 3d models are present in PCB.
    [ETH6C20MUX-B_Mask.gbr, ETH6C20MUX-B_Paste.gbr, ETH6C20MUX-B_SilkS.gbr, ETH6C20MUX-Bottom.gbr, ETH6C20MUX-Edge_Cuts.gbr, ETH6C20MUX-F_Mask.gbr, ETH6C20MUX-F_Paste.gbr, ETH6C20MUX-F_SilkS.gbr]
2019-10-02 Added SPI6C20MUX PCB module, part of ETH6C20MUX.
    [Connector.sch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]
2019-10-03 SPI6C20MUX layout done, bug fixes in ETH6C20MUX layout.
    [ETH6C20MUX.kicad_pcb, Relays.sch, SPI6C20MUX.kicad_pcb]
2019-10-08 Bug fix in TSR2 2450 footprint.
    [ETH6C20MUX.kicad_pcb]
2019-10-27 Added firmware software, based on zephyr OS.
    [ETH6C20MUX.kicad_pcb, SPI6C20MUX.kicad_pcb, scpi.g]
2019-11-09 Small updates in PCB design.
    [ETH6C20MUX.kicad_pcb, MCU.sch, Relays.sch, SPI6C20MUX.kicad_pcb]
2019-11-26 SPI module PCB modifications.
    [Relays.sch, SPI6C20MUX.kicad_pcb]
2019-12-01 Lwip ping works.
    [ETH6C20MUX.kicad_pcb, SPI6C20MUX.kicad_pcb]
2019-12-08 Software development. SPI flash write/read works correctly.
    [Connector.sch, ETH6C20MUX.sch, Ethernet.sch, MCU.sch, Power.sch, Relays.sch]
2019-12-13 Software development.
    [Relays.sch]
2019-12-19 Software and hardware development
    [Connector.sch, Power.sch, Relays.sch, SPI6C20MUX.kicad_pcb, SPI6C20MUX.sch]
2019-12-28 Bug fix in SCPI_CreateSPICommands
    [scpi_def.c]
2020-01-10 Bug fixes in software, still problem with relay index control.
    [main.c, matrix.h, scpi_def.c, spi_flash.c, spi_flash.h]
2020-04-18 Added pin swap for A,B,E and F.
    [ETH6C20MUX.kicad_pcb, Relays.sch]
2021-02-07 PCB redesign
    [Connector.sch, ETH6C20MUX.kicad_pcb, ETH6C20MUX.sch, Ethernet.sch, MCU.sch, Power.sch, Relays.sch]
2021-02-08 PCB design
    [Connector.sch, ETH6C20MUX.kicad_pcb, Ethernet.sch, MCU.sch]
2021-02-09 PCB layout
    [ETH6C20MUX.kicad_pcb, Relays.sch]
2021-02-11 Main PCB layout done
    [ETH6C20MUX.kicad_pcb, Relays.sch]
2021-02-11 Modifications in PCB main board.
    [ETH6C20MUX.kicad_pcb]
2021-02-13 PCB main and module layout.
    [Connector.sch, ETH6C20MUX.csv, ETH6C20MUX.kicad_pcb, ETH6C20MUX.ods, ETH6C20MUX_old.ods, MCU.sch, Relays.sch, SPI6C20MUX.kicad_pcb]
2021-02-13 PCB layouts done.
    [ETH6C20MUX.kicad_pcb, SPI6C20MUX.kicad_pcb]
2021-02-14 Added FreeRTOS, and fix the bugs in relay switching.
    [ETH6C20MUX.kicad_pcb]
2021-03-21 PCB modifications.
    [ETH6C20MUX.kicad_pcb, Ethernet.sch, MCU.sch, Relays.sch, SPI6C20MUX.kicad_pcb]
